minisystem/750-UTILITY/Panel/850_hole_centres.dxf

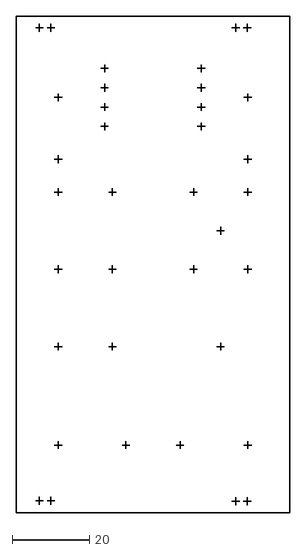
[picture p1: CAD file, 2017-03-22]
Panel/850_hole_centres.dxf
70.8 x 128.5
