minisystem/750-UTILITY/Panel/850_mechanical.dxf

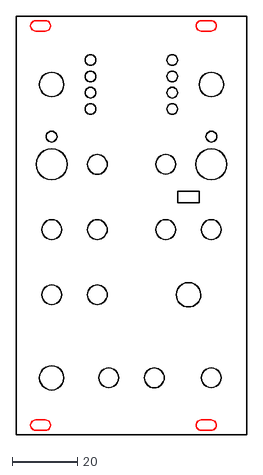
[picture p2: CAD file, 2017-03-22]
Panel/850_mechanical.dxf
70.8 x 128.5
