minisystem/750-UTILITY/Panel/750 LFO S&H NOISE SLEW-Edge.Cuts.dxf

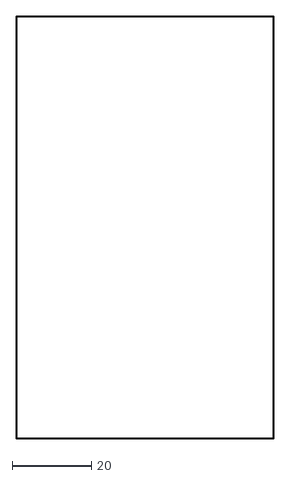
[picture p3: CAD file, 2017-03-21]
Panel/750 LFO S&H NOISE SLEW-Edge.Cuts.dxf
65.2 x 106.6
