minisystem/750-UTILITY/Panel/750 LFO S&H NOISE SLEW-Eco1.User.dxf

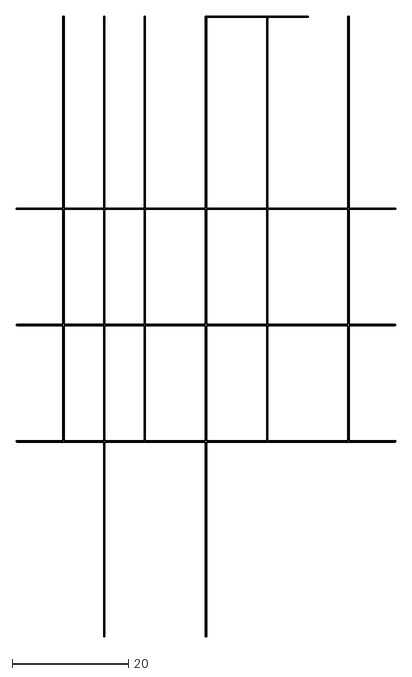
[picture p4: CAD file, 2017-03-21]
Panel/750 LFO S&H NOISE SLEW-Eco1.User.dxf
65.2 x 106.7
