minisystem/750-UTILITY/Panel/hole centres.dxf

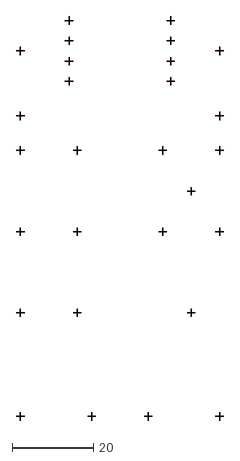
[picture p5: CAD file, 2016-12-11]
Panel/hole centres.dxf
51.0 x 99.5
