minisystem/750-UTILITY/Panel/panel outline.dxf

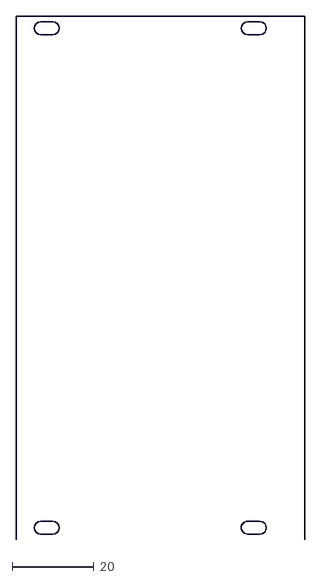
[picture p6: CAD file, 2016-12-10]
Panel/panel outline.dxf
70.8 x 128.5
