minisystem/750-UTILITY/(list of files, cad)

Other CAD files:
Panel/750 LFO S&H NOISE SLEW-F.SilkS.dxf
Panel/850_hole_centres.dwg
