minisystem/750-UTILITY/750 LFO S&H NOISE SLEW.pdf

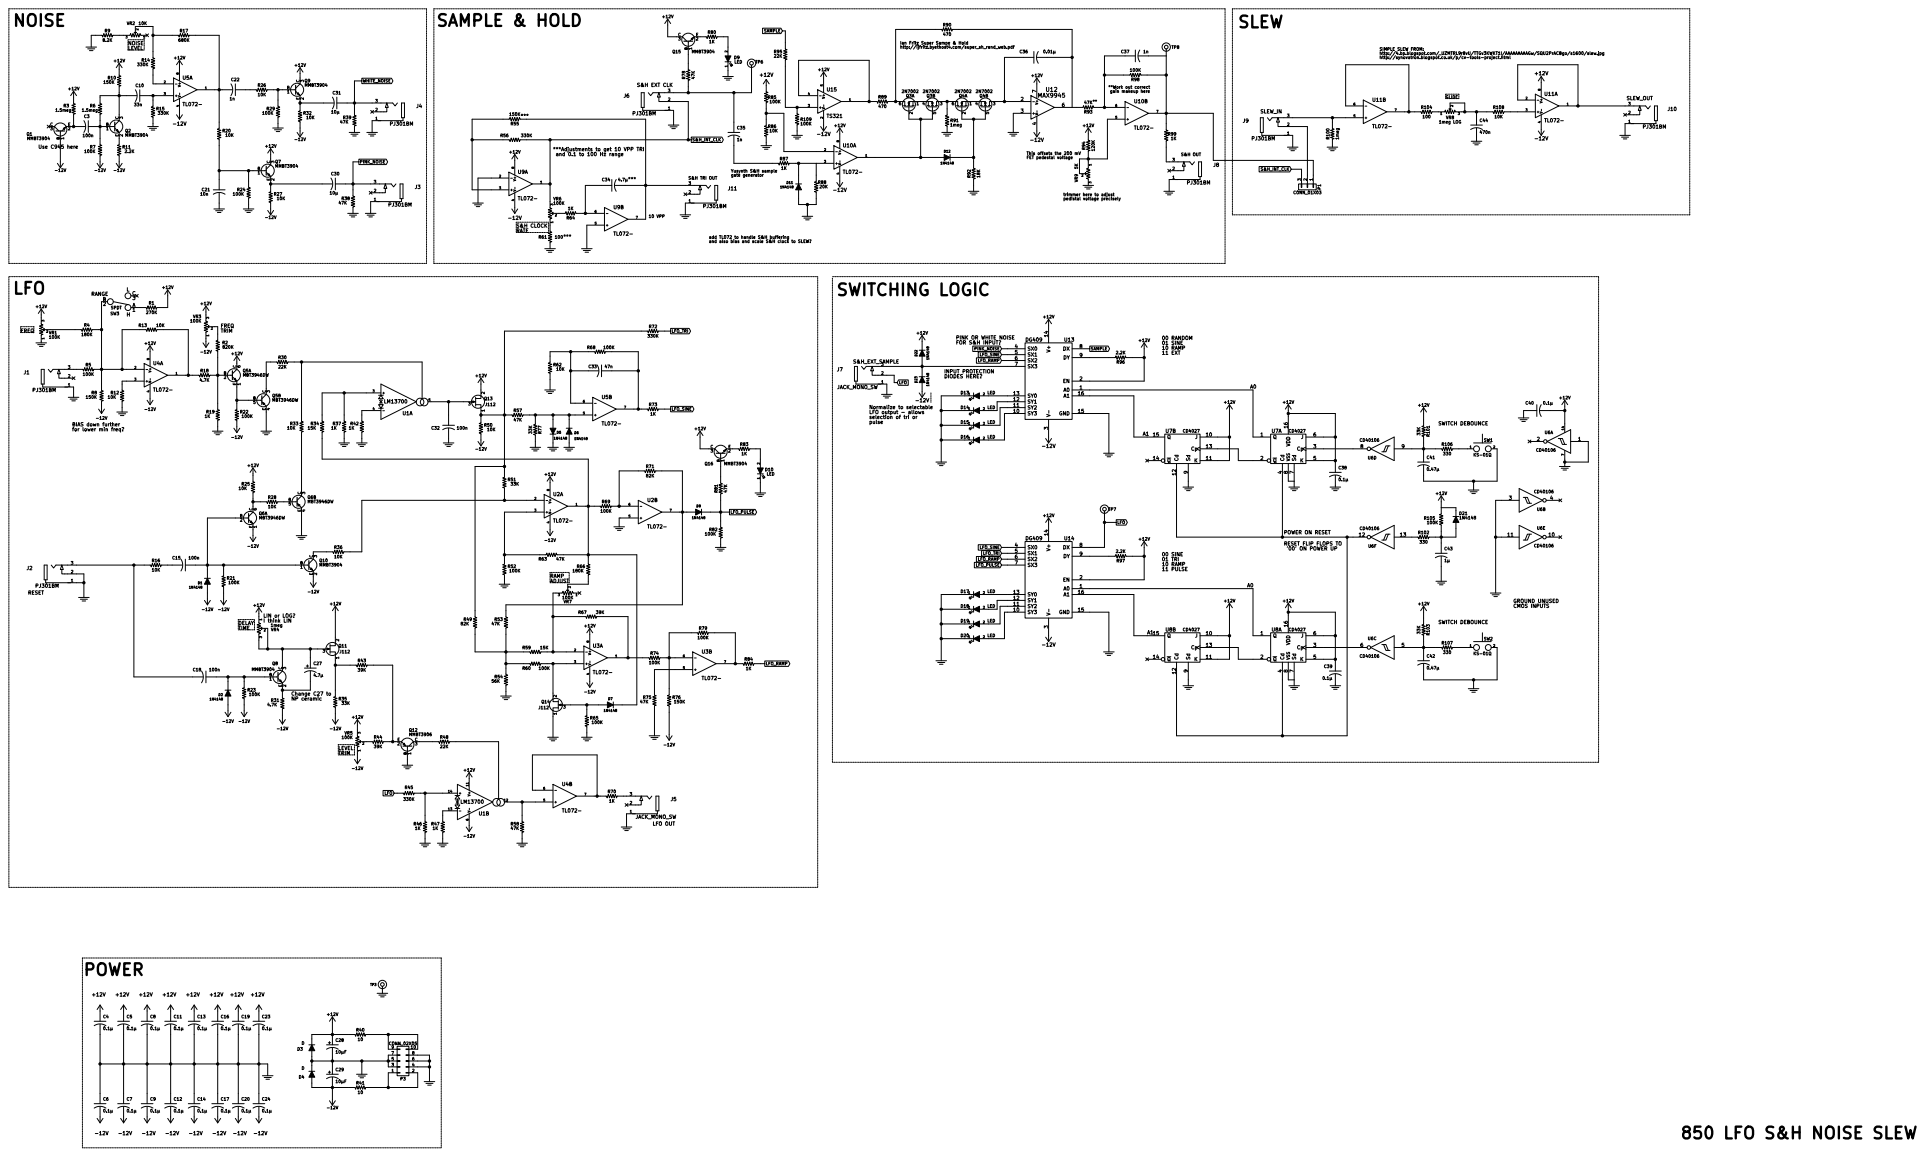
[picture p7: page 1]

Ian Fritz Super Sampe & Hold

100 SIMPLE SLEW FROM: http://4.bp.blogspot.com/_UZMTRL9r8vU/TTGv3KWKT1I/AAAAAAAAAGw/SQU2PrACBgo/s1600/slew.jpg

**Work out correct gain makeup here

***Adjustments to get 10 VPP TRI

This offsets the 200 mV FET pedestal voltage

trimmer here to adjust

and also bias and scale S&H clock to SLEW? BIAS down further

add TL072 to handle S&H buffering

PINK OR WHITE NOISE
FOR S&H INPUT?

LFO output - allows selection of tri or pulse

for lower min freq?

RESET FLIP FLOPS TO
'00' ON POWER UP

Change C27 to NP ceramic

0.1µ +12V POWER +12V | TP3
