minisystem/750-UTILITY/Panel/850_hole_centres.pdf

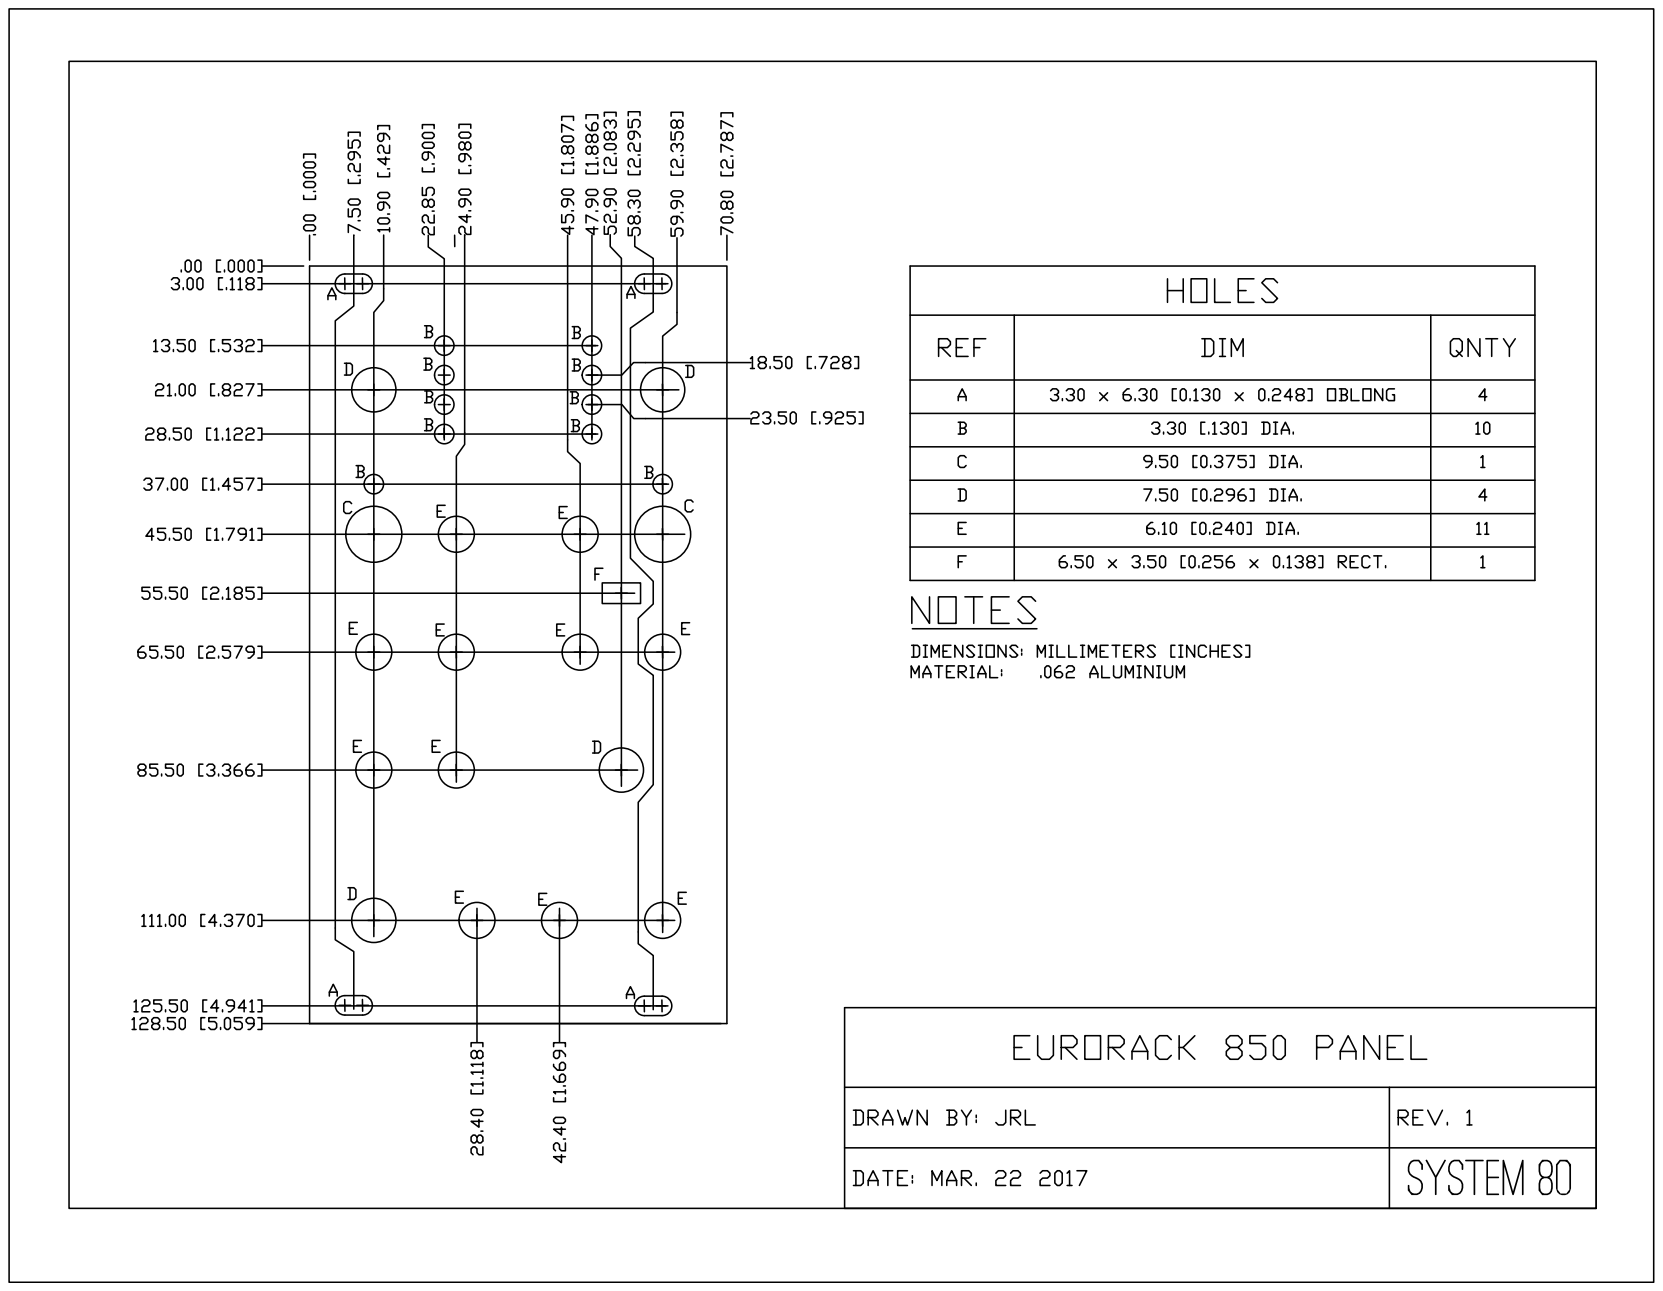
[picture p8: page 1]
