minisystem/750-UTILITY/Panel/750 LFO S&H NOISE SLEW-F.SilkS.pdf

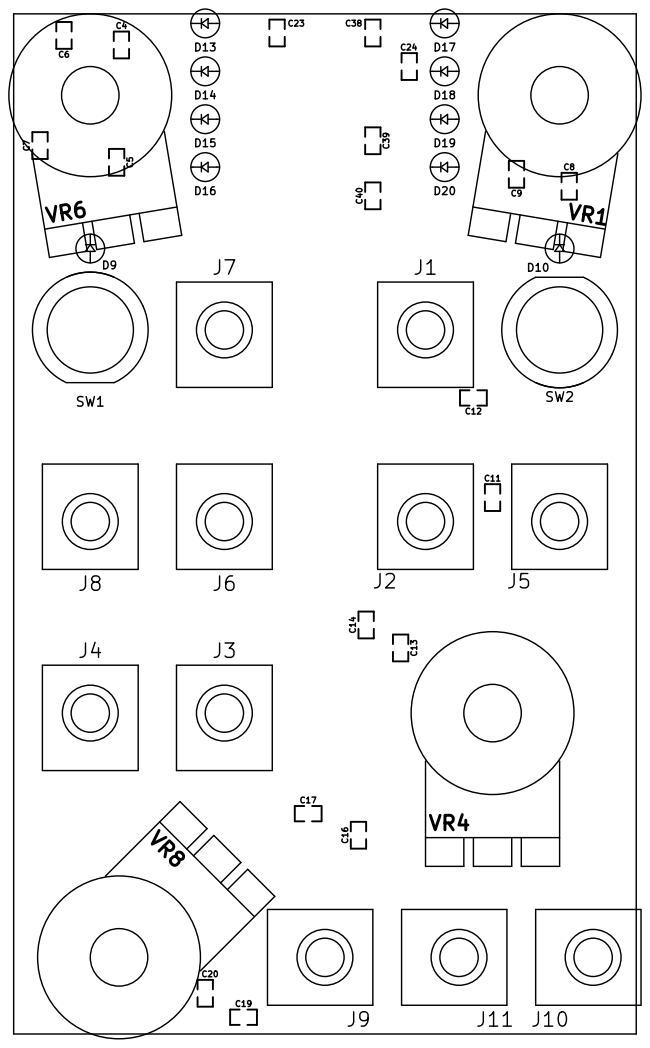
[picture p9: page 1]
