minisystem/750-UTILITY/Manual/850 Manual cover.pdf

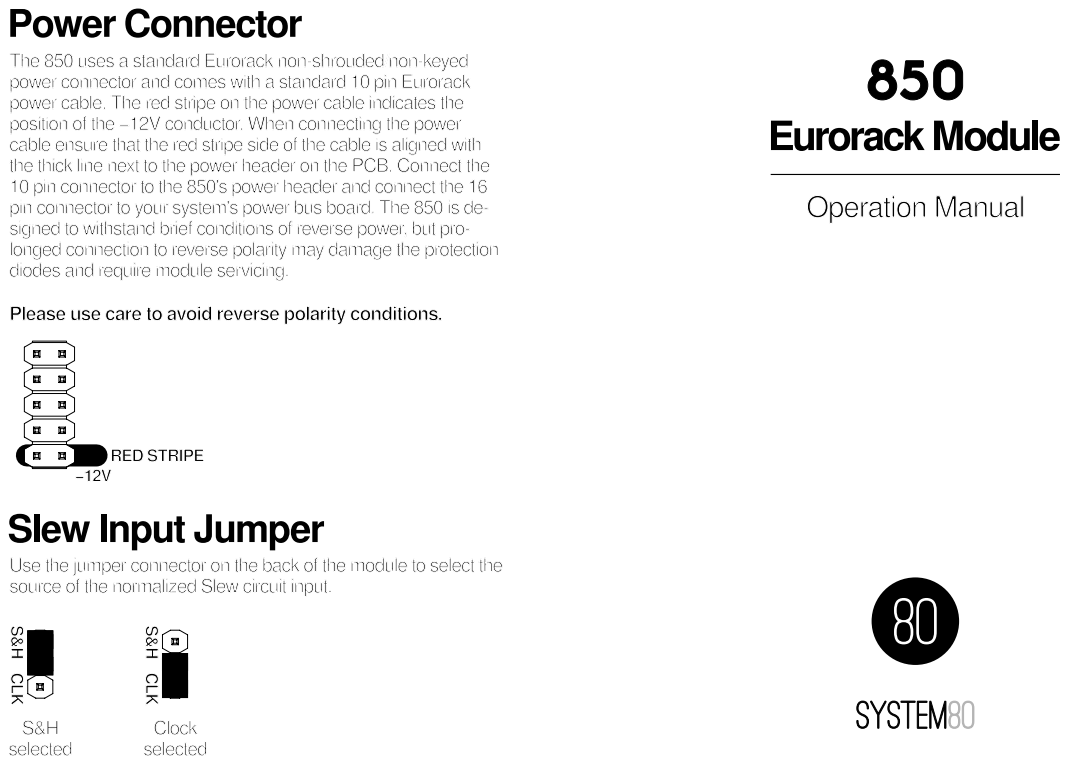
[picture p10: page 1]
