minisystem/750-UTILITY/Manual/850 Manual upload.pdf

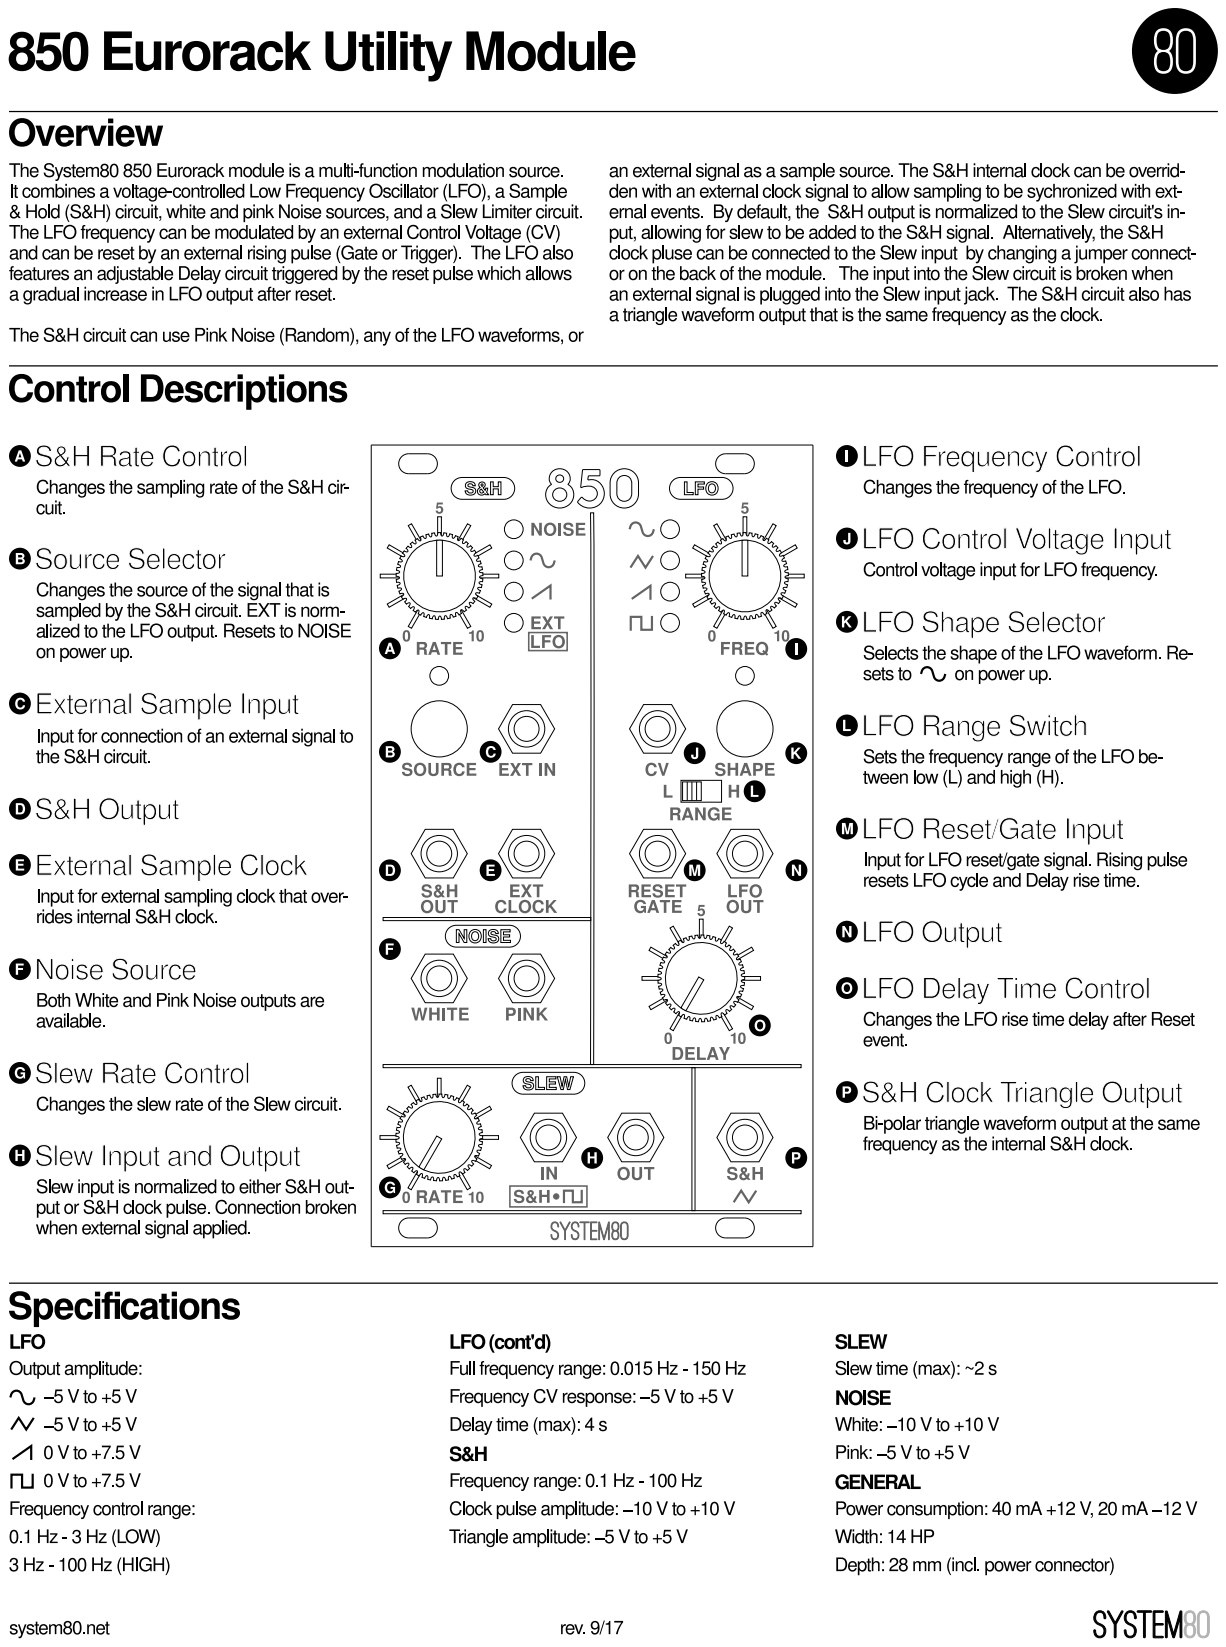
[picture p11: page 1]
