minisystem/750-UTILITY/Manual/850 Manual.pdf

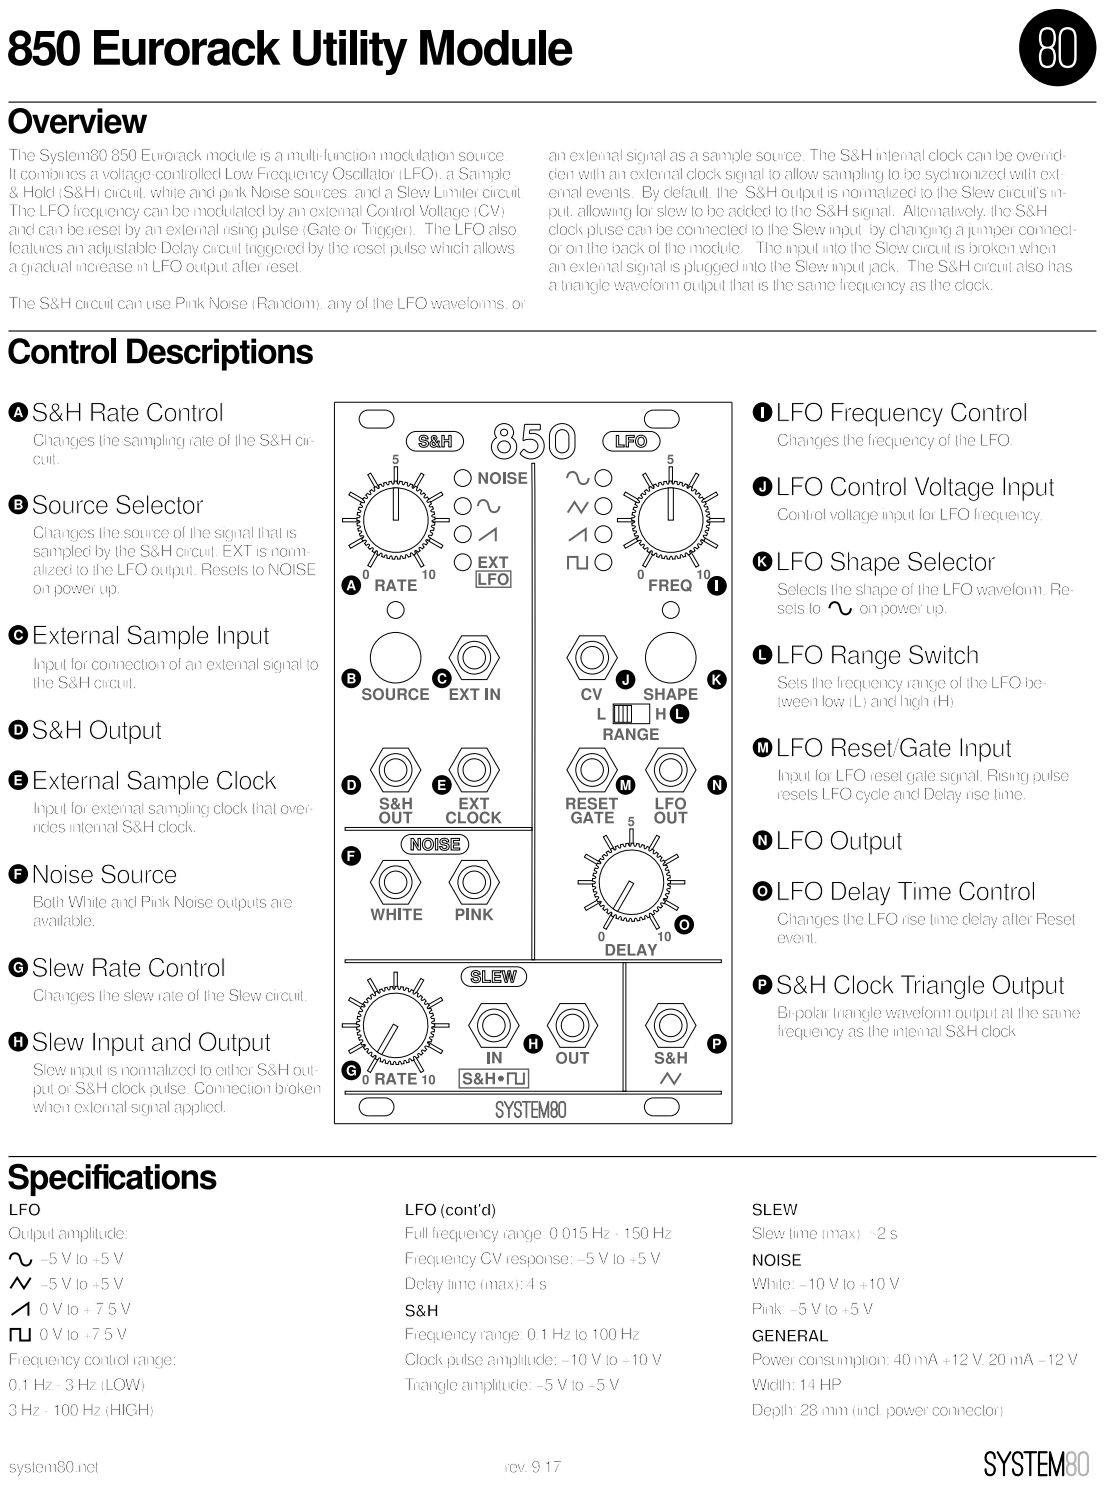
[picture p12: page 1]
