minisystem/750-UTILITY/750 LFO S&H NOISE SLEW.kicad_pcb

## KiCad design 750 LFO S&H NOISE SLEW.kicad_pcb (2018-03-14)

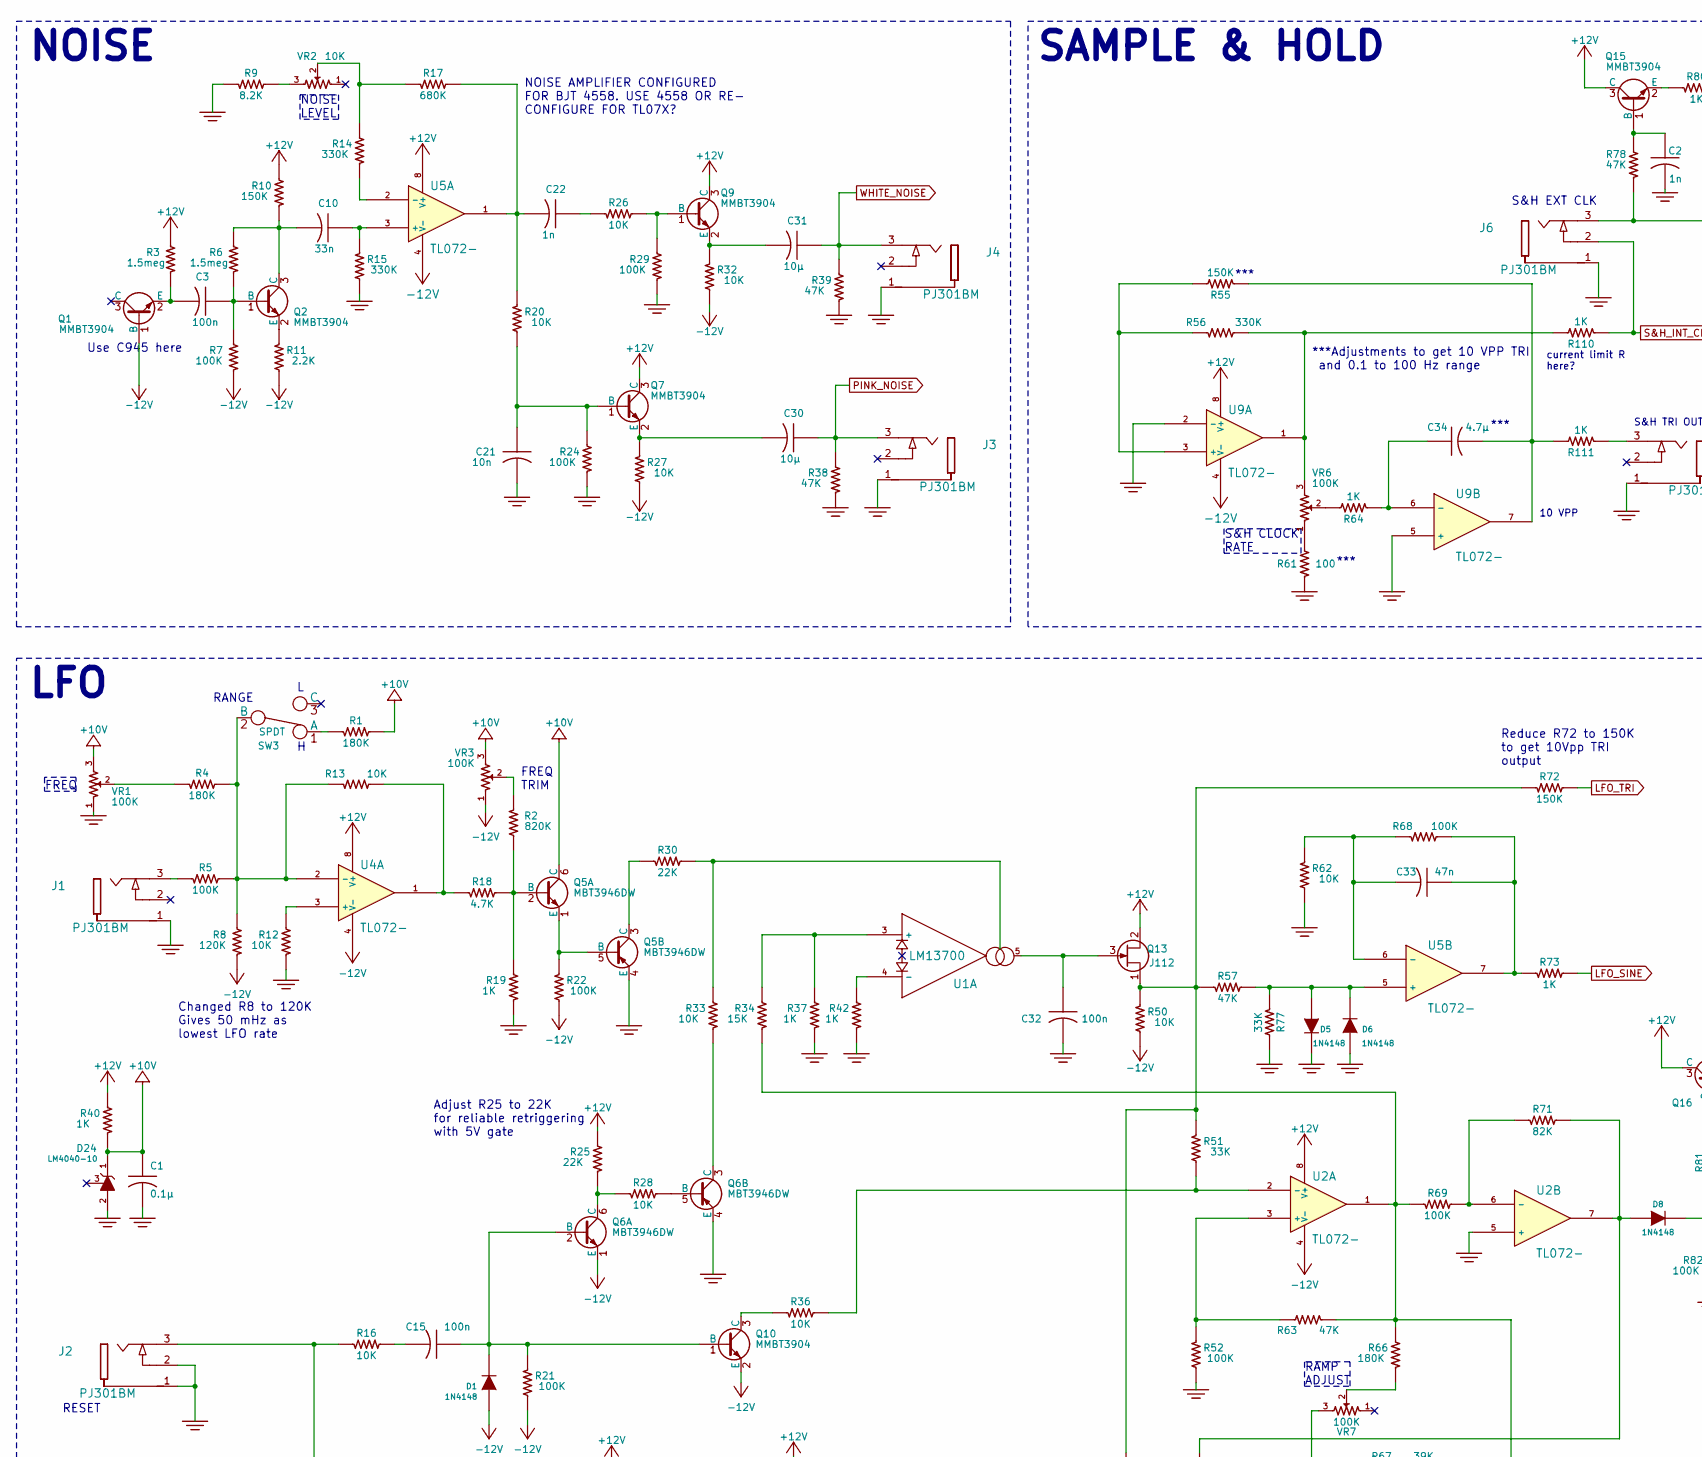
[picture p13: schematic 750 LFO S&H NOISE SLEW.sch, part in row 1, column 1]

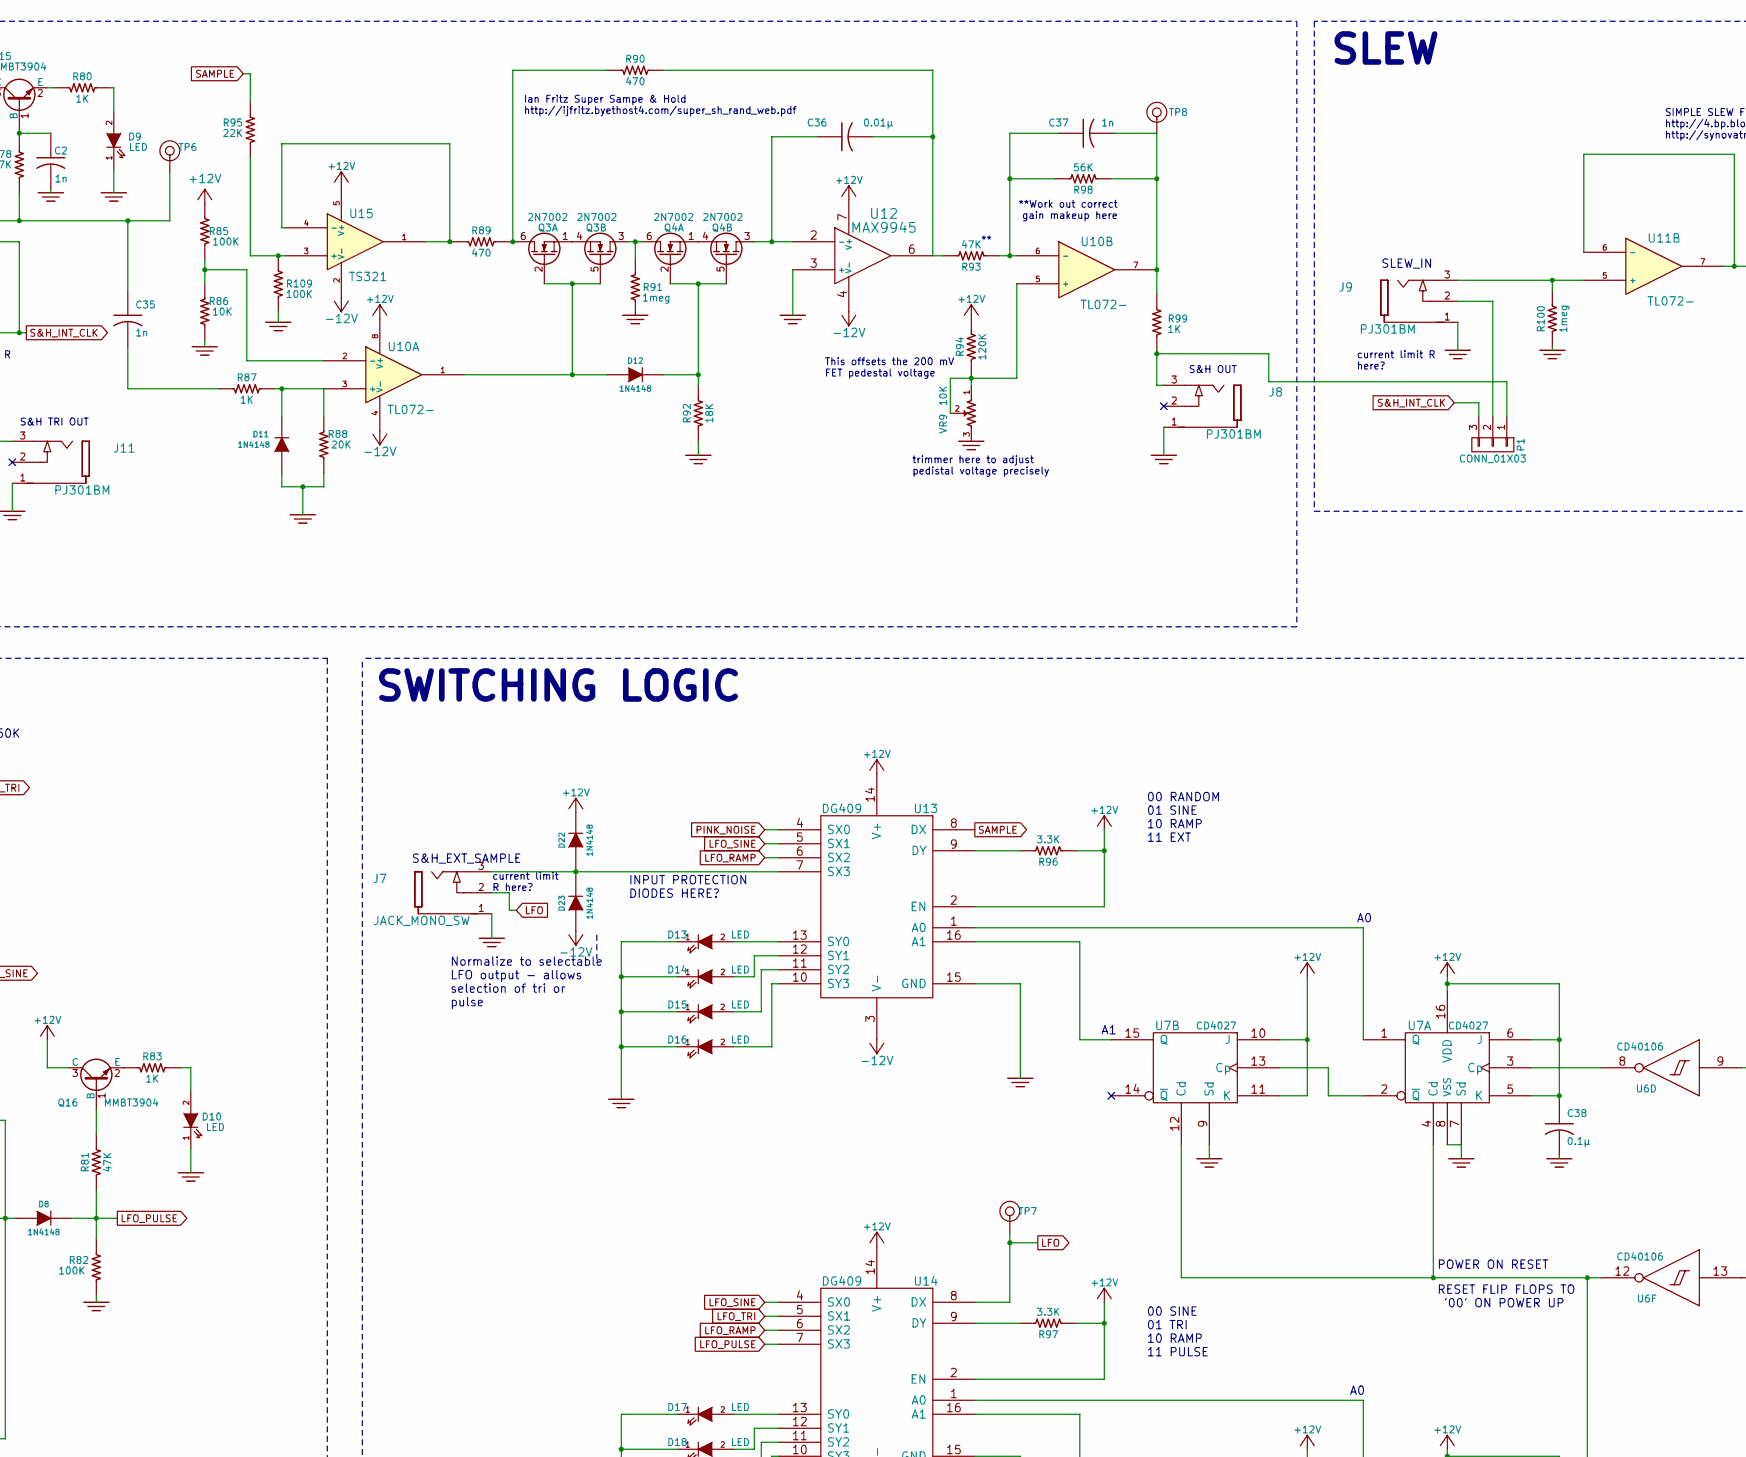
[picture p14: schematic 750 LFO S&H NOISE SLEW.sch, part in row 1, column 2]

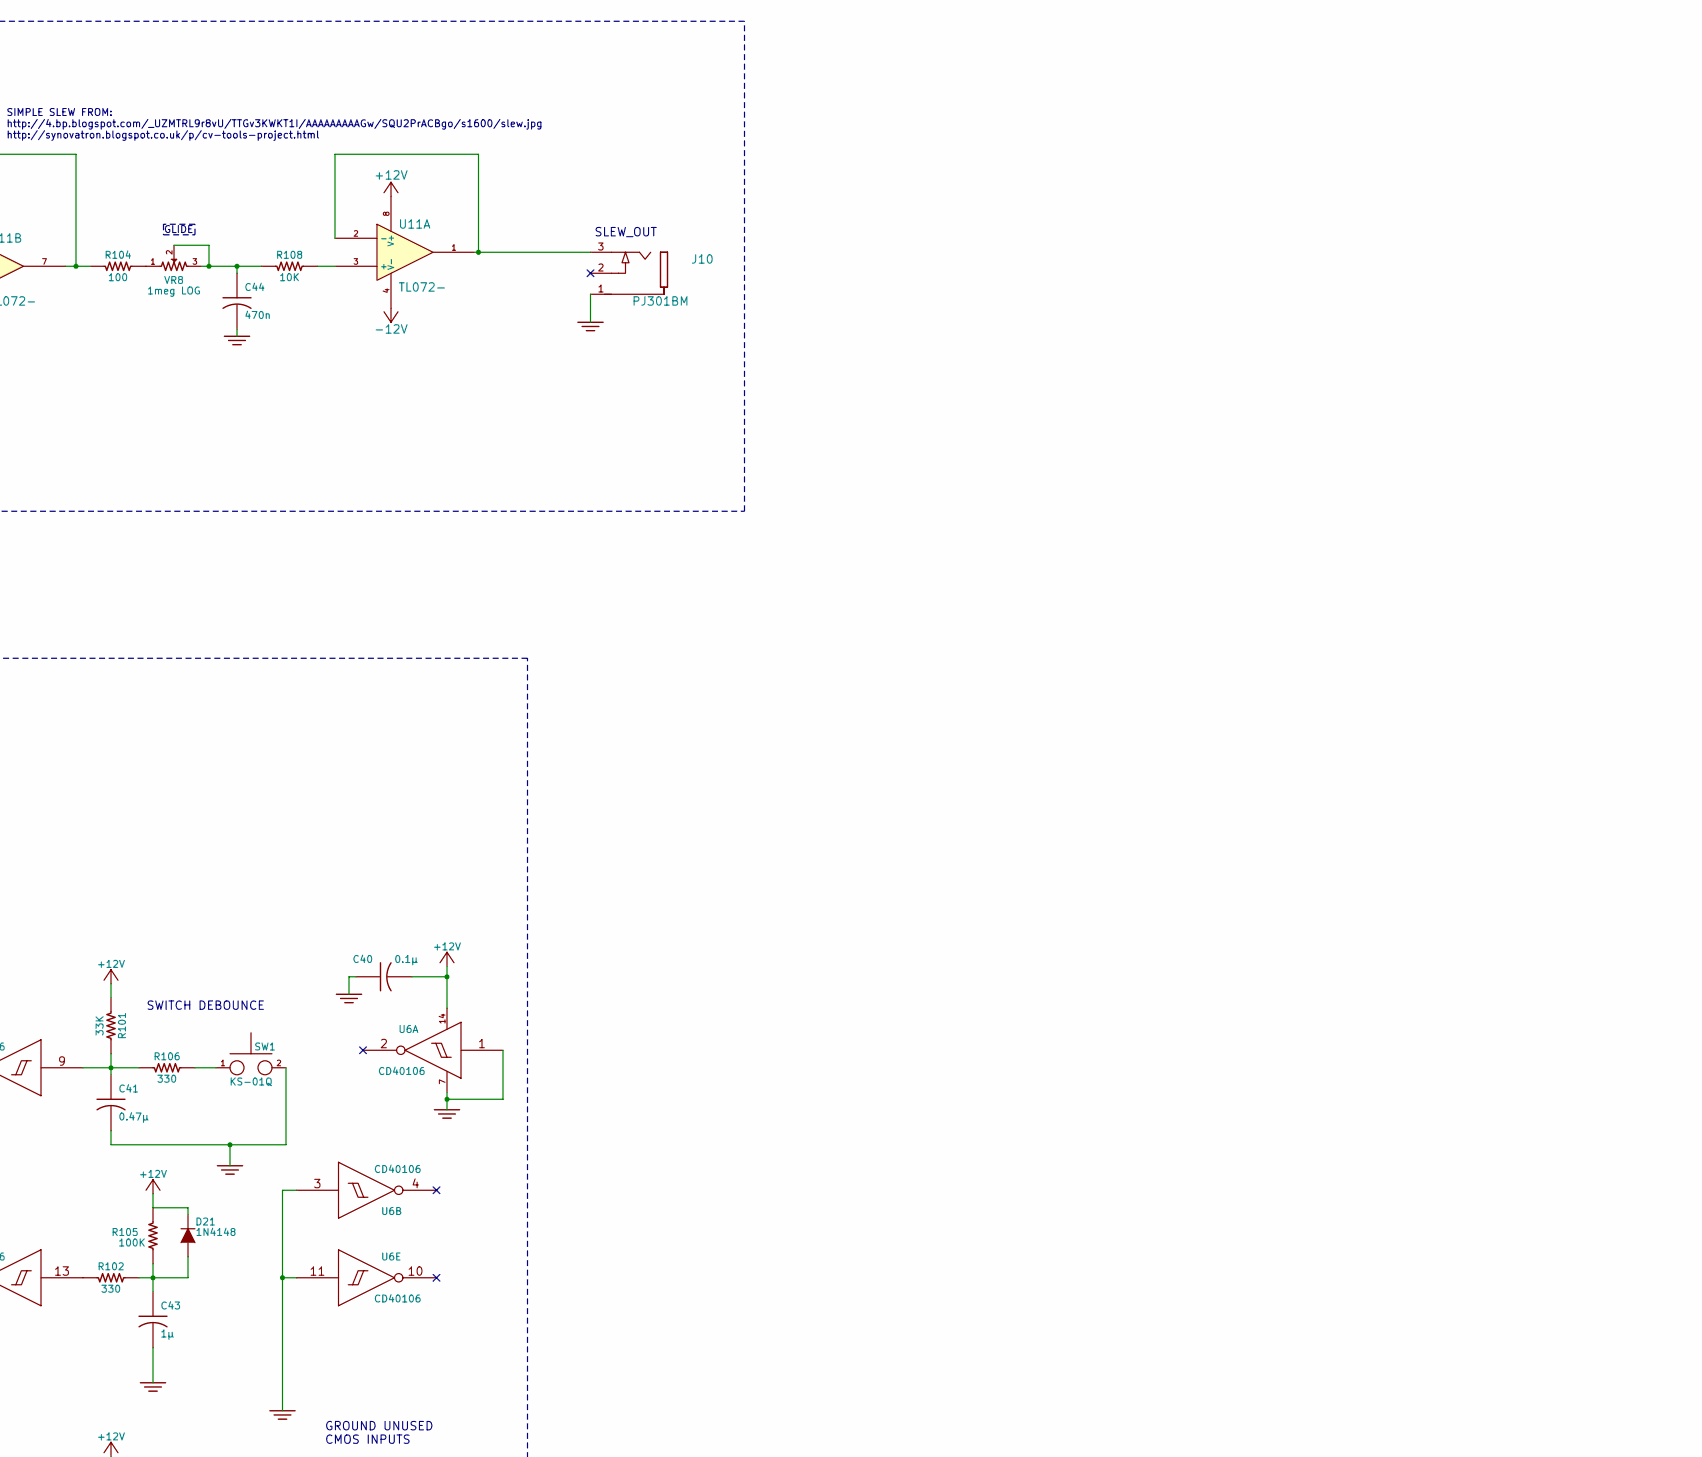
[picture p15: schematic 750 LFO S&H NOISE SLEW.sch, part in row 1, column 3]

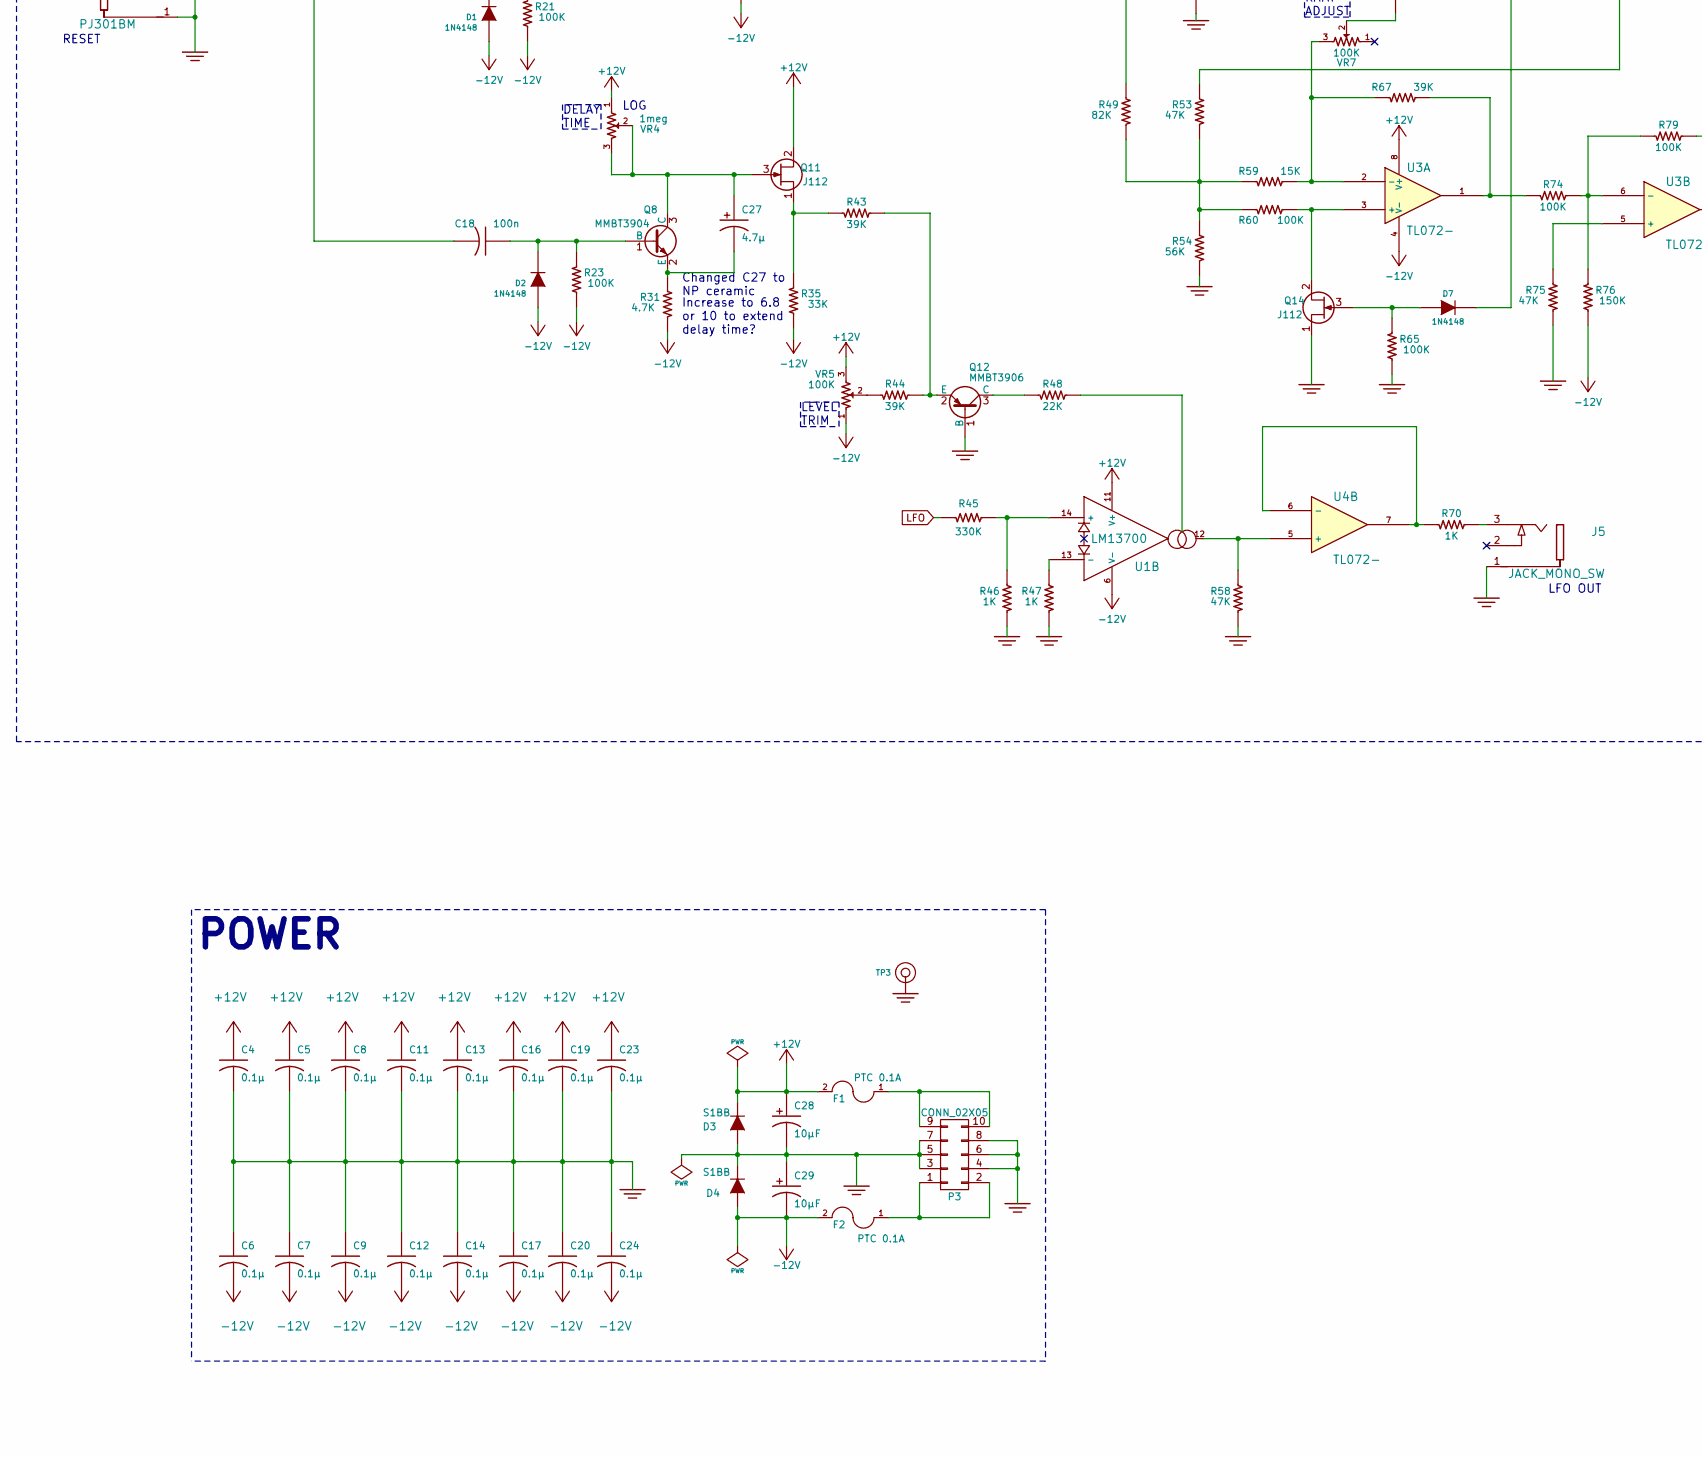
[picture p16: schematic 750 LFO S&H NOISE SLEW.sch, part in row 2, column 1]

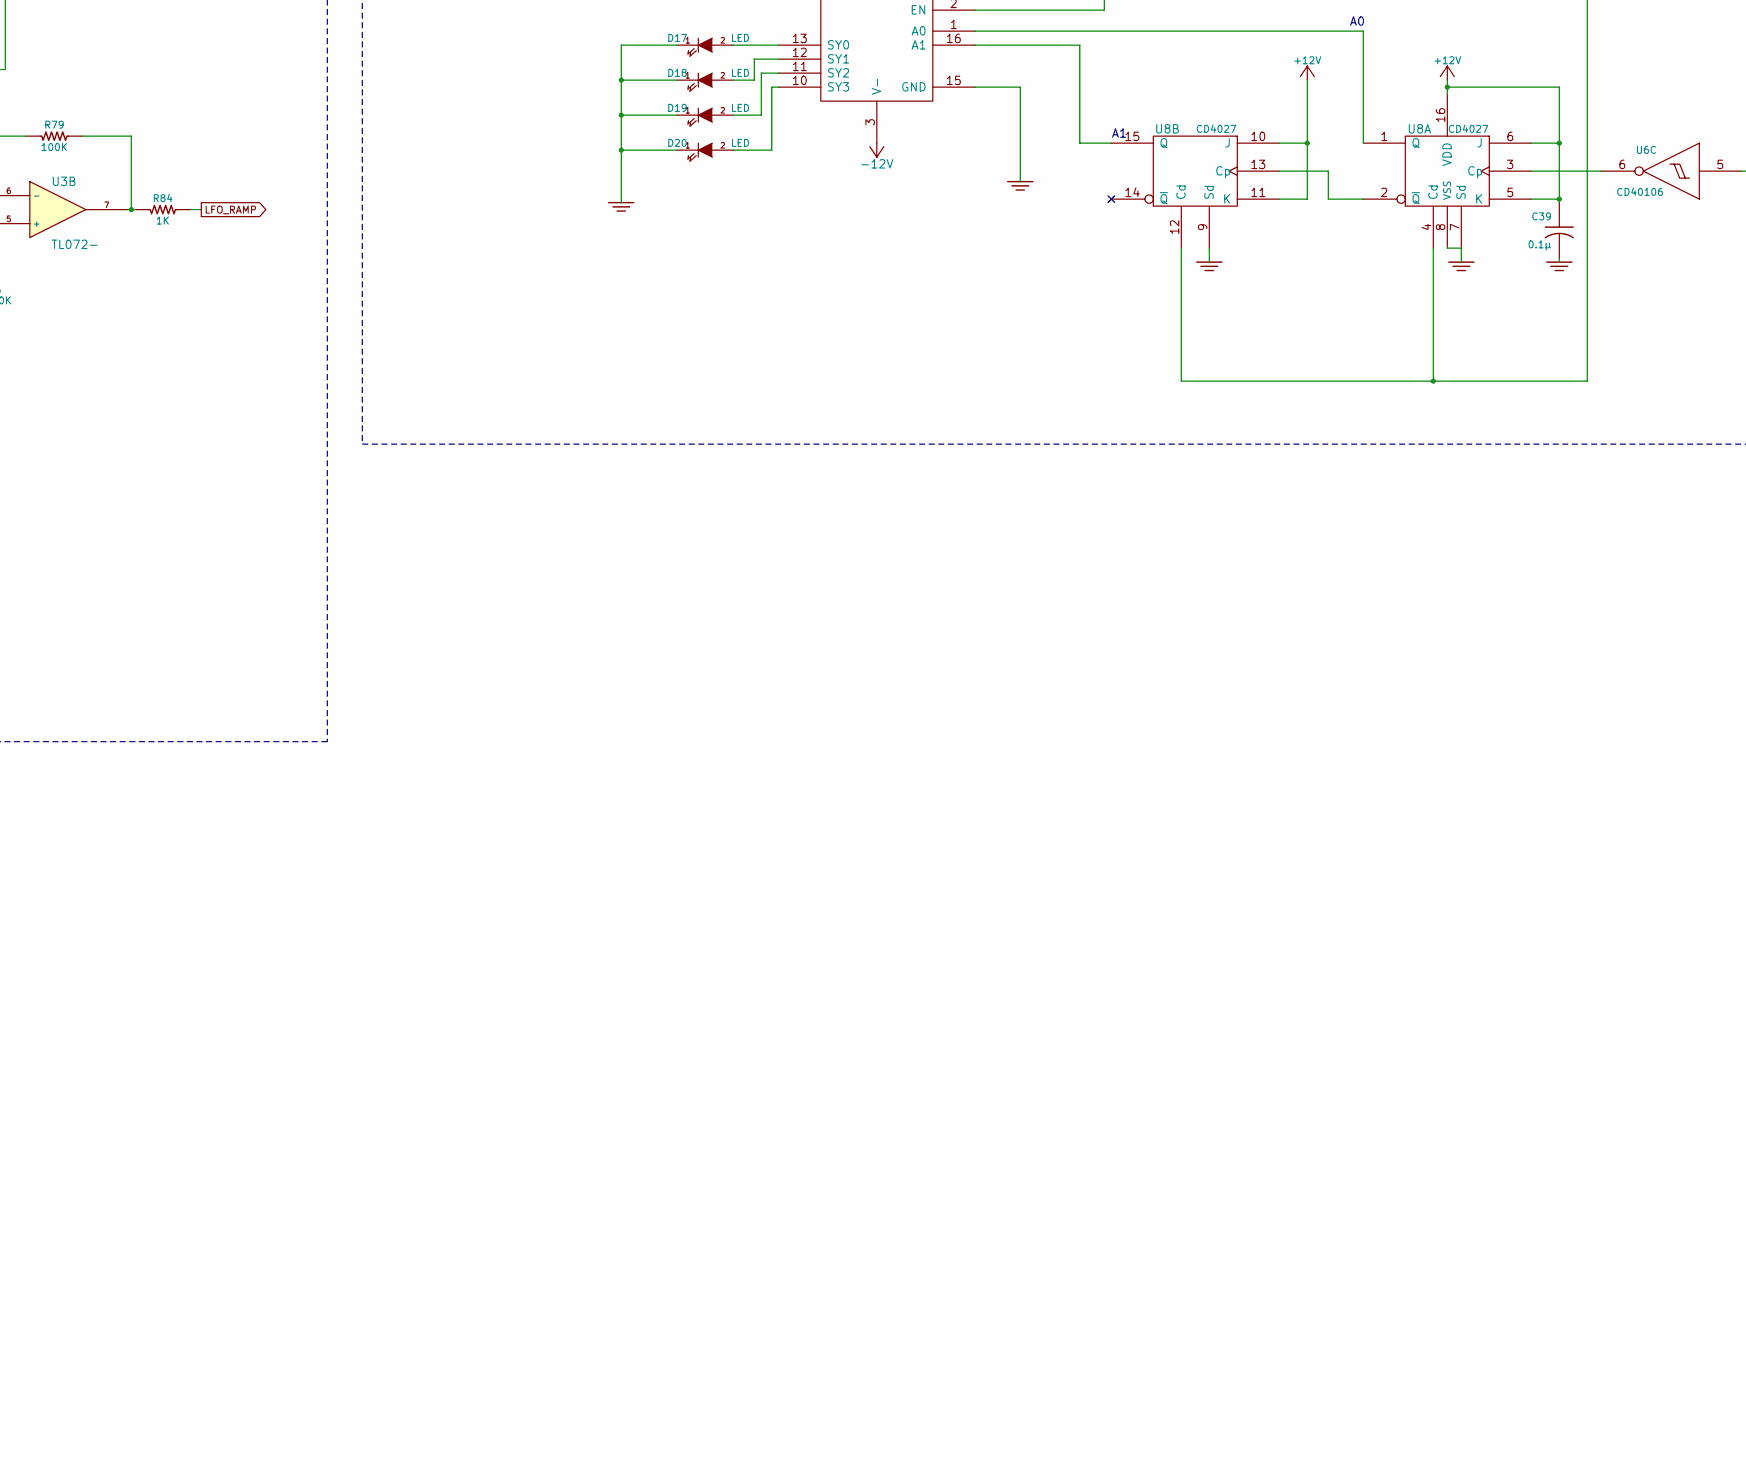
[picture p17: schematic 750 LFO S&H NOISE SLEW.sch, part in row 2, column 2]

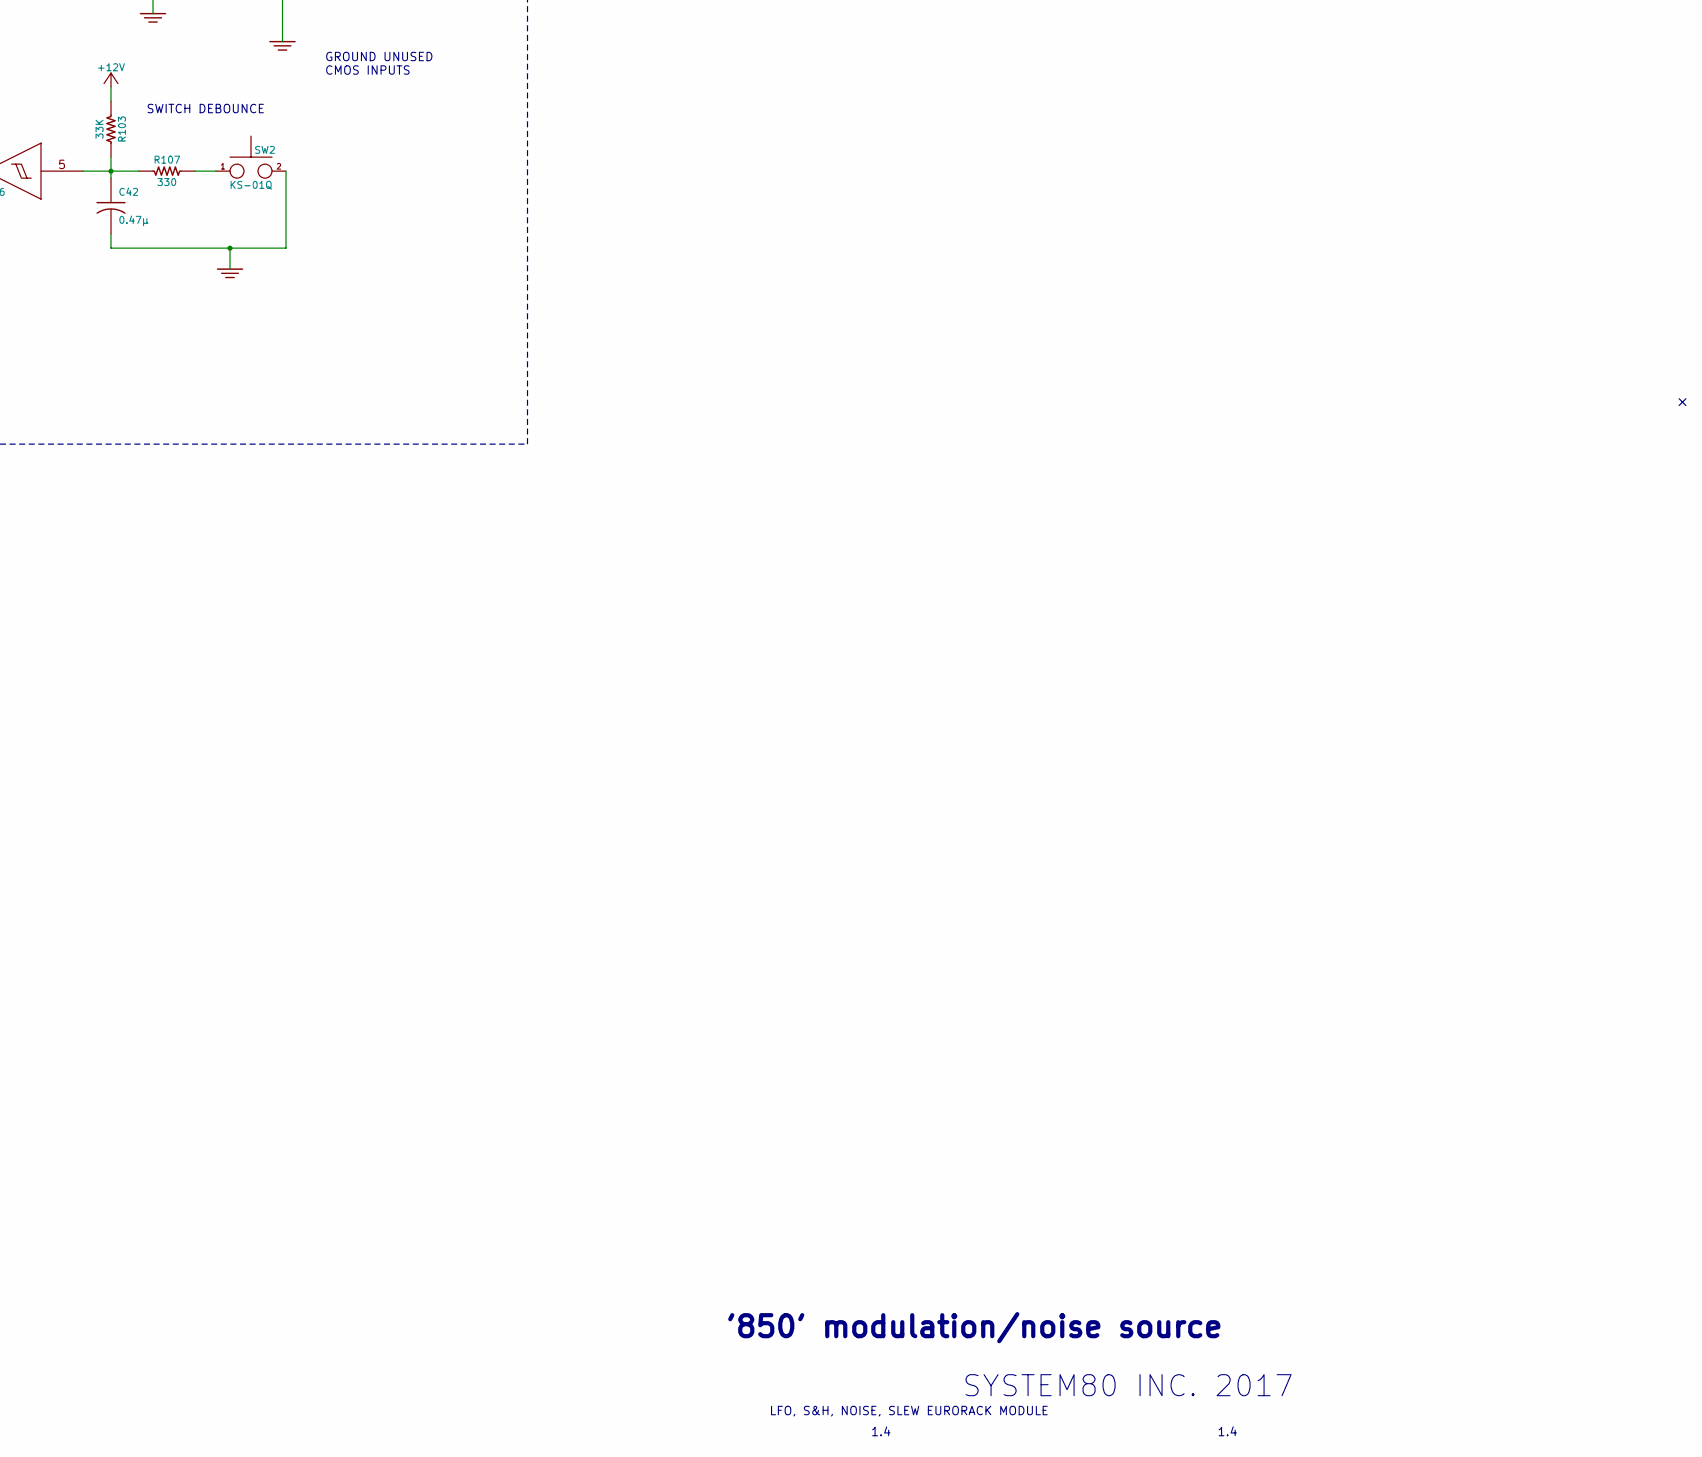
[picture p18: schematic 750 LFO S&H NOISE SLEW.sch, part in row 2, column 3]

Parts:
C1, C4, C5, C6, C7, C8, C9, C11, C12, C13, C14, C16, C17, C19, C20, C23, C24, C38, C39, C40: 0.1µ; SM0603-C-JRL
C2, C22, C35, C37: 1n; SM0603-C-JRL
C3, C15, C18, C32: 100n; SM0603-C-JRL
C10: 33n; SM0603-C-JRL
C21: 10n; SM0603-C-JRL
C27, C34: 4.7μ; SM0805-HAND
C28, C29: 10μF; c_elec_5x5.3
C30, C31: 10μ; SM0805-HAND
C33: 47n; SM0603-C-JRL
C36: 0.01μ; SM0603-C-JRL
C41, C42: 0.47μ; SM0603-C-JRL
C43: 1μ; SM0603-C-JRL
C44: 470n; CAP-5MM-BOX-0805-COMBO
D1, D2, D5, D6, D7, D8, D11, D12, D22, D23: 1N4148; SOD323-JRL
D3, D4: S1BB; SMB-1C2A
D9, D10, D13, D14, D15, D16, D17, D18, D19, D20: LED; 3MM-LED-C1A2
D21: 1N4148; SOD323-C1A2
D24: LM4040-10; SOT23-132-JRL
F1, F2: PTC 0.1A; C_0805
J1, J2, J3, J4, J6, J8, J9, J10, J11: PJ301BM; PJ-301B-JACK-SLOTS
J5, J7: JACK_MONO_SW; PJ-301B-JACK-SLOTS
P1: CONN_01X03; PAD_3
P3: CONN_02X05; Pin_Header_Straight_2x05
Q1, Q2, Q7, Q8, Q9, Q10, Q15, Q16: MMBT3904; SOT23-132-JRL
Q3, Q4: 2N7002; SOT363-JRL
Q5, Q6: MBT3946DW; SOT363-JRL
Q11, Q13, Q14: J112; SOT23-JRL
Q12: MMBT3906; SOT23-132-JRL
R1, R4, R66: 180K; SM0603-R-JRL
R2: 820K; SM0603-R-JRL
R3, R6: 1.5meg; SM0603-R-JRL
R5, R7, R21, R22, R23, R24, R29, R52, R60, R65, R68, R69, R74, R79, R82, R85, R105, R109: 100K; SM0603-R-JRL
R8, R94: 120K; SM0603-R-JRL
R9: 8.2K; SM0603-R-JRL
R10, R55, R72, R76: 150K; SM0603-R-JRL
R11: 2.2K; SM0603-R-JRL
R12, R13, R16, R20, R26, R27, R28, R32, R33, R36, R50, R62, R86, R108: 10K; SM0603-R-JRL
R14, R15, R45, R56: 330K; SM0603-R-JRL
R17: 680K; SM0603-R-JRL
R18, R31: 4.7K; SM0603-R-JRL
R19, R37, R40, R42, R46, R47, R64, R70, R73, R80, R83, R84, R87, R99, R110, R111: 1K; SM0603-R-JRL
R25, R30, R48, R95: 22K; SM0603-R-JRL
R34, R59: 15K; SM0603-R-JRL
R35, R51, R77, R101, R103: 33K; SM0603-R-JRL
R38, R39, R53, R57, R58, R63, R75, R78, R81, R93: 47K; SM0603-R-JRL
R43, R44, R67: 39K; SM0603-R-JRL
R49, R71: 82K; SM0603-R-JRL
R54, R98: 56K; SM0603-R-JRL
R61, R104: 100; SM0603-R-JRL
R88: 20K; SM0603-R-JRL
R89, R90: 470; SM0603-R-JRL
R91, R100: 1meg; SM0603-R-JRL
R92: 18K; SM0603-R-JRL
R96, R97: 3.3K; SM0603-R-JRL
R102, R106, R107: 330; SM0603-R-JRL
SW1, SW2: KS-01Q; KS-01Q-02-JRL
SW3: SPDT; SS-12F45-1P2T-SLIDE
TP3: CONN_1; TEST_POINT_LOOP_4592
TP6, TP7, TP8: CONN_1; TEST_POINT_SMALL
U1: LM13700; SO16-JRL
U2, U3, U4, U5, U9, U10, U11: TL072-; TSSOP8-JRL
U6: CD40106; TSSOP-14_4.4x5mm_Pitch0.65mm
U7, U8: CD4027; TSSOP-16_4.4x5mm_Pitch0.65mm
U12: MAX9945; MSOP-8_3x3mm_Pitch0.65mm
U13, U14: DG409; SO16-JRL
U15: TS321; SOT-23-5
VR1, VR6: 100K; RV16A-41-JRL
VR2, VR9: 10K; TC33X-2
VR3, VR5, VR7: 100K; TC33X-2
VR4: 1meg; RV16A-41-JRL
VR8: 1meg LOG; RV16A-41-JRL

Connections:
+10V: C1.1, D24.1 (K), Q5.6 (C), R1.2, R40.2, VR1.3, VR3.3
+12V: C4.1, C5.1, C8.1, C11.1, C13.1, C16.1, C19.1, C23.1, C28.1 (+), C38.1, C39.1, C40.2, D3.1 (K), D21.1 (K), D22.2 (K), F1.2, Q7.3 (C), Q9.3 (C), Q11.2 (D), Q13.2 (D), Q15.3 (C), Q16.3 (C), R3.1, R10.1, R25.1, R40.1, R85.2, R94.2, R96.1, R97.1, R101.2, R103.2, R105.2, U1.11 (V+), U2.8 (V+), U3.8 (V+), U4.8 (V+), U5.8 (V+), U6.14 (VDD), U7.5 (K), U7.6 (J), U7.10 (J), U7.11 (K), U7.16 (VDD), U8.5 (K), U8.6 (J), U8.10 (J), U8.11 (K), U8.16 (VDD), U9.8 (V+), U10.8 (V+), U11.8 (V+), U12.7 (V+), U13.2 (EN), U13.14 (V+), U14.2 (EN), U14.14 (V+), U15.5 (V+), VR4.1, VR5.3
-12V: C6.2, C7.2, C9.2, C12.2, C14.2, C17.2, C20.2, C24.2, C29.2 (-), D1.1 (A), D2.1 (A), D4.2 (A), D23.1 (A), F2.2, Q1.1 (B), Q6.1 (E), Q10.2 (E), R7.2, R8.2, R11.2, R21.2, R22.2, R23.2, R27.2, R31.2, R32.2, R35.2, R50.2, R76.2, U1.6 (V-), U2.4 (V-), U3.4 (V-), U4.4 (V-), U5.4 (V-), U9.4 (V-), U10.4 (V-), U11.4 (V-), U12.4 (V-), U13.3 (V-), U14.3 (V-), U15.2 (V-), VR3.1, VR5.1
GND: C1.2, C2.2, C4.2, C5.2, C6.1, C7.1, C8.2, C9.1, C11.2, C12.1, C13.2, C14.1, C16.2, C17.1, C19.2, C20.1, C21.2, C23.2, C24.1, C28.2 (-), C29.1 (+), C32.2, C38.2, C39.2, C40.1, C41.2, C42.2, C43.2, C44.2, D3.2 (A), D4.1 (K), D5.2 (K), D6.1 (A), D9.1 (K), D10.1 (K), D11.1 (A), D13.1 (K), D14.1 (K), D15.1 (K), D16.1 (K), D17.1 (K), D18.1 (K), D19.1 (K), D20.1 (K), D24.2 (A), J1.1, J2.1, J2.2, J3.1, J4.1, J5.1, J6.1, J7.1, J8.1, J9.1, J10.1, J11.1, P3.3, P3.4, P3.5, P3.6, P3.7, P3.8, Q5.4 (E), Q6.4 (E), Q12.1 (B), Q14.1 (S), R9.1, R12.2, R15.2, R19.2, R24.2, R29.2, R37.2, R38.2, R39.2, R42.2, R46.2, R47.2, R52.2, R54.2, R58.2, R61.1, R62.2, R65.2, R75.2, R77.2, R82.2, R86.2, R88.2, R91.2, R92.1, R100.2, R109.1, SW1.2, SW2.2, TP3.1, U2.5 (+), U6.1 (In), U6.3 (In), U6.7 (VSS), U6.11 (In), U7.7 (Sd), U7.8 (VSS), U7.9 (Sd), U8.7 (Sd), U8.8 (VSS), U8.9 (Sd), U9.2 (-), U9.5 (+), U12.3 (+), U13.15 (GND), U14.15 (GND), VR1.1, VR9.3
LFO: J7.2, R45.2, TP7.1, U14.8 (DX)
LFO_PULSE: D8.2 (K), R81.1, R82.1, U14.7 (SX3)
LFO_RAMP: R84.2, U13.6 (SX2), U14.6 (SX2)
LFO_SINE: R73.2, U13.5 (SX1), U14.4 (SX0)
LFO_TRI: R72.2, U14.5 (SX1)
unnamed: C2.1, Q15.1 (B), R78.2
unnamed: C3.1, Q2.1 (B), R6.2, R7.1
unnamed: C3.2, Q1.2 (E), R3.2
unnamed: C10.1, R15.1, U5.3 (+)
unnamed: C10.2, Q2.3 (C), R6.1, R10.2
unnamed: C15.1, D1.2 (K), Q6.2 (B), Q10.1 (B), R21.1
unnamed: C15.2, R16.2
unnamed: C18.1, D2.2 (K), Q8.1 (B), R23.1
unnamed: C18.2, J2.3, R16.1
unnamed: C21.1, Q7.1 (B), R20.2, R24.1
unnamed: C22.1, R26.1
unnamed: C22.2, R17.2, R20.1, U5.1
unnamed: C27.1 (+), Q8.3 (C), Q11.3 (G), VR4.2, VR4.3
unnamed: C27.2 (-), Q8.2 (E), R31.1
unnamed: C30.2, Q7.2 (E), R27.1
unnamed: C31.2, Q9.2 (E), R32.1
unnamed: C32.1, Q13.3 (G), U1.5
unnamed: C33.1, R68.2, R73.1, U5.7
unnamed: C33.2, R62.1, R68.1, U5.6 (-)
unnamed: C34.1, R64.1, U9.6 (-)
unnamed: C34.2, R55.1, R111.2, U9.7
unnamed: C35.1, J6.3, R78.1, TP6.1
unnamed: C35.2, R87.1
unnamed: C36.1, Q4.3 (D), U12.2 (-)
unnamed: C36.2, R90.1, R93.2, U12.6
unnamed: C37.1, R93.1, R98.2, U10.6 (-)
unnamed: C37.2, R98.1, R99.2, TP8.1, U10.7
unnamed: C41.1, R101.1, R106.1, U6.9 (In)
unnamed: C42.1, R103.1, R107.1, U6.5 (In)
unnamed: C43.1, D21.2 (A), R102.2, R105.1
unnamed: C44.1, R108.2, VR8.2, VR8.3
unnamed: D5.1 (A), D6.2 (K), R57.2, R77.1, U5.5 (+)
unnamed: D7.1 (A), Q14.3 (G), R65.1
unnamed: D7.2 (K), R34.2, R63.2, R66.1, R69.1, U2.1
unnamed: D8.1 (A), R53.1, R71.2, U2.7
unnamed: D9.2 (A), R80.2
unnamed: D10.2 (A), R83.2
unnamed: D11.2 (K), R87.2, R88.1, U10.3 (+)
unnamed: D12.1 (A), Q3.2 (G), Q3.5 (G), U10.1
unnamed: D12.2 (K), Q4.2 (G), Q4.5 (G), R92.2
unnamed: D13.2 (A), U13.13 (SY0)
unnamed: D14.2 (A), U13.12 (SY1)
unnamed: D15.2 (A), U13.11 (SY2)
unnamed: D16.2 (A), U13.10 (SY3)
unnamed: D17.2 (A), U14.13 (SY0)
unnamed: D18.2 (A), U14.12 (SY1)
unnamed: D19.2 (A), U14.11 (SY2)
unnamed: D20.2 (A), U14.10 (SY3)
unnamed: D22.1 (A), D23.2 (K), J7.3, U13.7 (SX3)
unnamed: F1.1, P3.9, P3.10
unnamed: F2.1, P3.1, P3.2
unnamed: J1.3, R5.1
unnamed: J5.3, R70.2
unnamed: J8.3, P1.1, R99.1
unnamed: J9.2, P1.2
unnamed: J9.3, R100.1, U11.5 (+)
unnamed: J10.3, U11.1, U11.2 (-)
unnamed: J11.3, R111.1
unnamed: Q2.2 (E), R11.1
unnamed: Q3.1 (S), Q3.4 (S)
unnamed: Q3.3 (D), Q4.6 (D), R91.1
unnamed: Q3.6 (D), R89.1, R90.2
unnamed: Q4.1 (S), Q4.4 (S)
unnamed: Q5.1 (E), Q5.5 (B), R22.1
unnamed: Q5.2 (B), R2.2, R18.2, R19.1
unnamed: Q5.3 (C), R30.1
unnamed: Q6.3 (C), R33.2
unnamed: Q6.5 (B), R28.2
unnamed: Q6.6 (C), R25.2, R28.1
unnamed: Q9.1 (B), R26.2, R29.1
unnamed: Q10.3 (C), R36.1
unnamed: Q11.1 (S), R35.1, R43.1
unnamed: Q12.2 (E), R43.2, R44.2
unnamed: Q12.3 (C), R48.1
unnamed: Q13.1 (S), R49.1, R50.1, R51.1, R57.1, R72.1
unnamed: Q14.2 (D), R60.2, U3.3 (+)
unnamed: Q15.2 (E), R80.1
unnamed: Q16.1 (B), R81.2
unnamed: Q16.2 (E), R83.1
unnamed: R1.1, SW3.1 (A)
unnamed: R2.1, VR3.2
unnamed: R4.1, VR1.2
unnamed: R9.2, VR2.3
unnamed: R12.1, U4.3 (+)
unnamed: R4.2, R5.2, R8.1, R13.1, SW3.2 (B), U4.2 (-)
unnamed: R13.2, R18.1, U4.1
unnamed: R14.1, R17.1, VR2.2
unnamed: R14.2, U5.2 (-)
unnamed: R30.2, R33.1, U1.1
unnamed: R34.1, R37.1, U1.3 (+)
unnamed: R36.2, R51.2, U2.2 (-)
unnamed: R42.1, U1.4 (-)
unnamed: R44.1, VR5.2
unnamed: R45.1, R46.1, U1.14 (+)
unnamed: R47.1, U1.13 (-)
unnamed: R48.2, U1.16
unnamed: R49.2, R53.2, R54.1, R59.1, R60.1
unnamed: R52.1, R63.1, U2.3 (+)
unnamed: R55.2, R56.2, U9.3 (+)
unnamed: R58.1, U1.12, U4.5 (+)
unnamed: R59.2, R67.1, U3.2 (-), VR7.3
unnamed: R61.2, VR6.1
unnamed: R64.2, VR6.2
unnamed: R66.2, VR7.2
unnamed: R67.2, R74.1, U3.1
unnamed: R69.2, R71.1, U2.6 (-)
unnamed: R70.1, U4.6 (-), U4.7
unnamed: R74.2, R76.1, R79.1, U3.6 (-)
unnamed: R75.1, U3.5 (+)
unnamed: R79.2, R84.1, U3.7
unnamed: R85.1, R86.1, U10.2 (-)
unnamed: R89.2, U15.1, U15.4 (-)
unnamed: R94.1, U10.5 (+), VR9.1, VR9.2
unnamed: R96.2, U13.9 (DY)
unnamed: R97.2, U14.9 (DY)
unnamed: R102.1, U6.13 (In)
unnamed: R104.1, VR8.1
unnamed: R104.2, U11.6 (-), U11.7
unnamed: R106.2, SW1.1
unnamed: R107.2, SW2.1
unnamed: R108.1, U11.3 (+)
unnamed: R95.1, R109.2, U15.3 (+)
unnamed: R56.1, R110.2, U9.1, VR6.3
unnamed: U6.6 (Out), U8.3 (Cp)
unnamed: U6.8 (Out), U7.3 (Cp)
unnamed: U6.12 (Out), U7.4 (Cd), U7.12 (Cd), U8.4 (Cd), U8.12 (Cd)
unnamed: U7.2 (~Q), U7.13 (Cp)
unnamed: U8.2 (~Q), U8.13 (Cp)
unnamed: U7.1 (Q), U13.1 (A0)
unnamed: U7.15 (Q), U13.16 (A1)
unnamed: U8.1 (Q), U14.1 (A0)
unnamed: U8.15 (Q), U14.16 (A1)
PINK_NOISE: C30.1, J3.3, R38.1, U13.4 (SX0)
S&H_INT_CLK: J6.2, P1.3, R110.1
SAMPLE: R95.2, U13.8 (DX)
WHITE_NOISE: C31.1, J4.3, R39.1

Notes on the sheet:
POWER
GLIDE
S&H CLOCK RATE
10 VPP
***
***Adjustments to get 10 VPP TRI and 0.1 to 100 Hz range
This offsets the 200 mV FET pedestal voltage
Ian Fritz Super Sampe & Hold http://ijfritz.byethost4.com/super_sh_rand_web.pdf
SLEW_IN
SIMPLE SLEW FROM: http://4.bp.blogspot.com/_UZMTRL9r8vU/TTGv3KWKT1I/AAAAAAAAAGw/SQU2PrACBgo/s1600/slew.jpg http://synovatron.blogspot.co.uk/p/cv-tools-project.html
S&H EXT CLK
S&H_EXT_SAMPLE
SLEW_OUT
00 RANDOM 01 SINE 10 RAMP 11 EXT
POWER ON RESET
SWITCH DEBOUNCE
GROUND UNUSED CMOS INPUTS
RESET FLIP FLOPS TO '00' ON POWER UP
00 SINE 01 TRI 10 RAMP 11 PULSE
RAMP ADJUST
RESET
LEVEL TRIM
LFO OUT
NOISE
SAMPLE & HOLD
LFO
SWITCHING LOGIC
SLEW
NOISE LEVEL
DELAY TIME
FREQ
S&H OUT
**Work out correct gain makeup here
FREQ TRIM
INPUT PROTECTION DIODES HERE?
Normalize to selectable LFO output - allows selection of tri or pulse
trimmer here to adjust pedistal voltage precisely
Changed R8 to 120K Gives 50 mHz as lowest LFO rate
S&H TRI OUT
RANGE
LOG
Changed C27 to NP ceramic
Use C945 here
Increase to 6.8 or 10 to extend delay time?
NOISE AMPLIFIER CONFIGURED FOR BJT 4558. USE 4558 OR RE- CONFIGURE FOR TL07X?
current limit R here?
current limit R here?
Adjust R25 to 22K for reliable retriggering with 5V gate
Reduce R72 to 150K to get 10Vpp TRI output
SYSTEM80 INC. 2017
1.4
'850' modulation/noise source
LFO, S&H, NOISE, SLEW EURORACK MODULE
