minisystem/750-UTILITY/750 LFO S&H NOISE SLEW.kicad_pcb

## KiCad design 750 LFO S&H NOISE SLEW.kicad_pcb (continued)

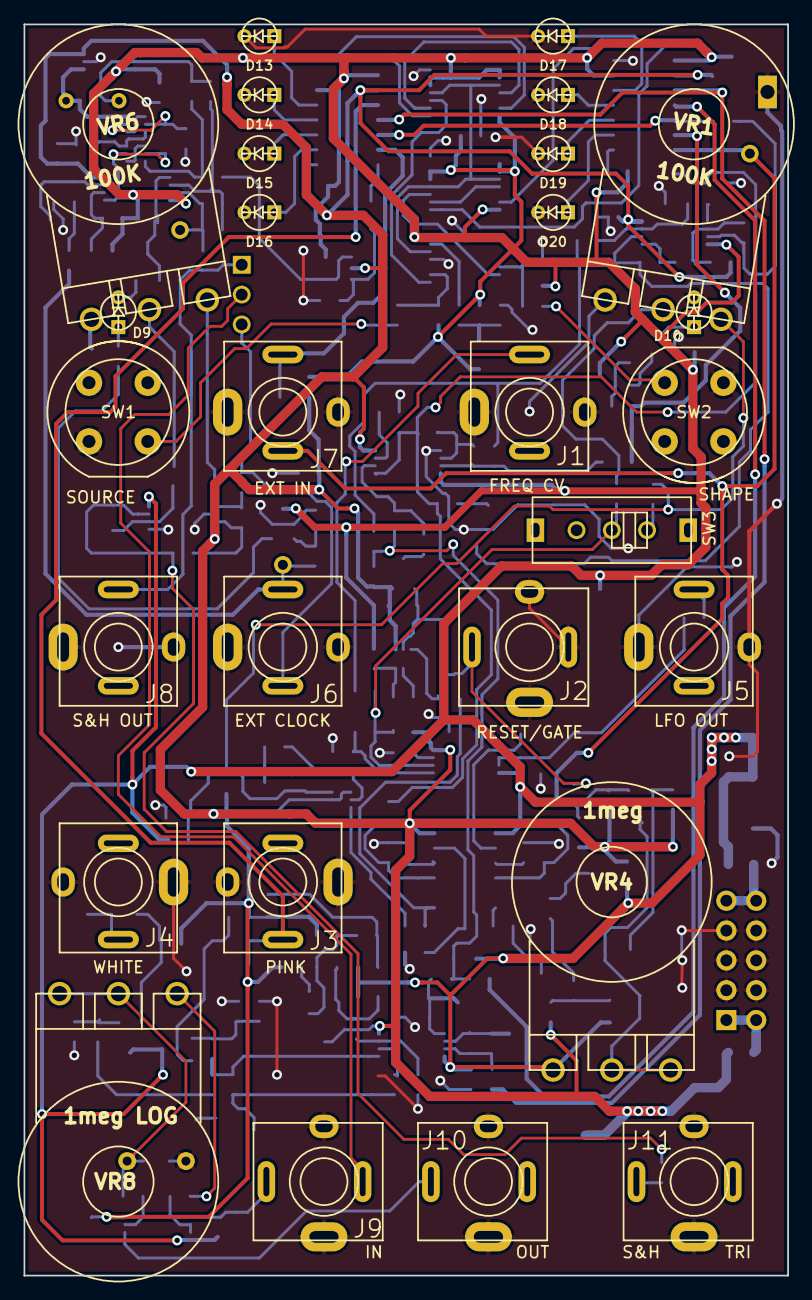
[picture p19: board 750 LFO S&H NOISE SLEW.kicad_pcb from above]

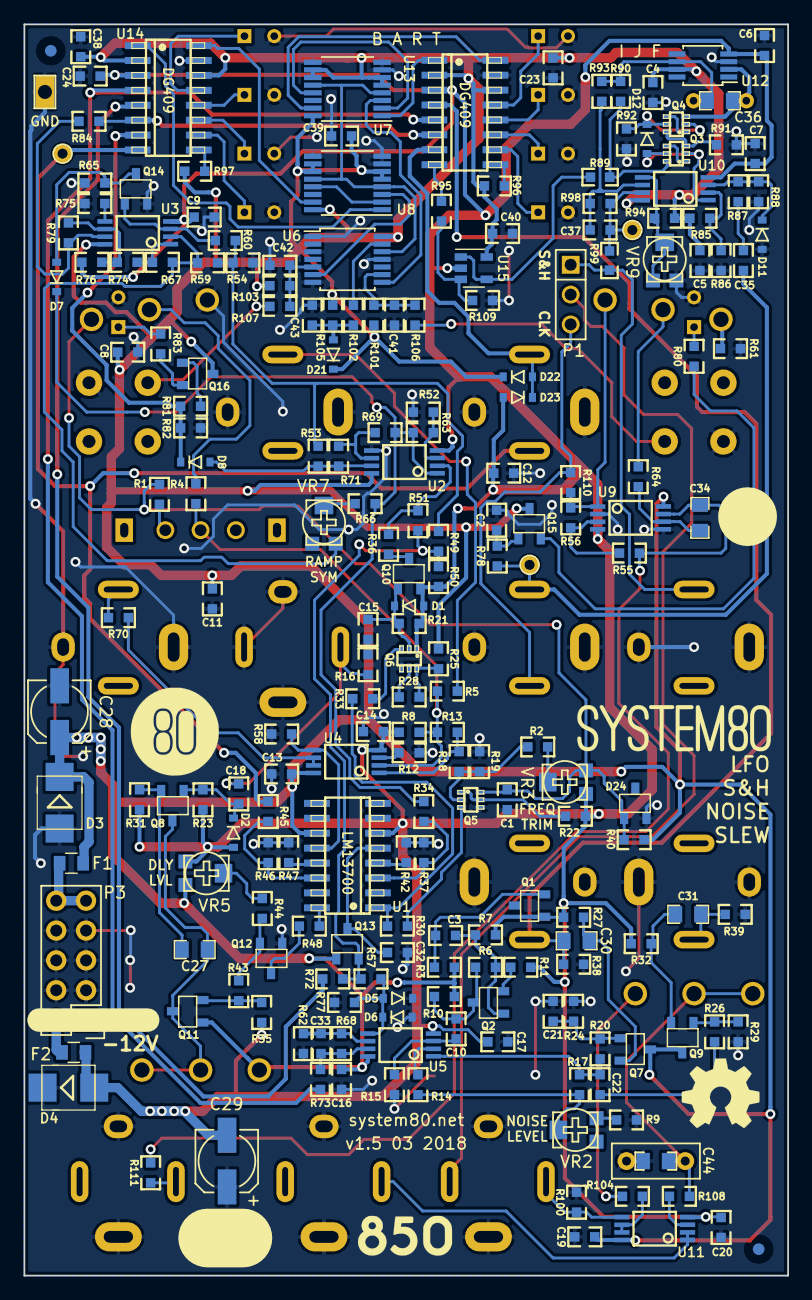
[picture p20: board 750 LFO S&H NOISE SLEW.kicad_pcb from below]

Board: 2 copper layers, 65.0 x 106.5 mm, 238 parts (210 on the bottom side), 145 nets.
