minisystem/750-UTILITY/(commit log)

2016-03-13 working on 150 LFO
    [750 LFO S&H NOISE SLEW.sch]
2016-03-14 schematic more or less captured. Still need to check and also confirm noise circuit
    [750 LFO S&H NOISE SLEW.sch]
2016-03-14 tidy up a bit. Could start part assignment and rough layout now
    [750 LFO S&H NOISE SLEW.sch]
2016-03-16 noise source done. removed redundant power-on-reset circuit
    [750 LFO S&H NOISE SLEW.sch]
2016-03-17 tidy up. next step: annotate
    [750 LFO S&H NOISE SLEW.sch]
2016-03-17 put PNP and NPN in LFO expo converter into single 3946 package, little bit of clean up
    [750 LFO S&H NOISE SLEW.sch]
2016-03-17 added filtered rails for noise circuit a la TR-808
    [750 LFO S&H NOISE SLEW.sch]
2016-03-18 annotated, footprints assinged, netlist generated
    [750 LFO S&H NOISE SLEW.sch]
2016-03-18 started placing comps on PCB. jacks, pots and LEDs placed
    [750 LFO S&H NOISE SLEW.sch]
2016-03-18 more component placement
    [750 LFO S&H NOISE SLEW.kicad_pcb, 750 LFO S&H NOISE SLEW.sch]
2016-04-09 placing components, starting a bit from scratch
    [750 LFO S&H NOISE SLEW.kicad_pcb, 750 LFO S&H NOISE SLEW.sch]
2016-04-10 placing and routing. so slow...
    [750 LFO S&H NOISE SLEW.kicad_pcb]
2016-04-11 almost done placing LFO, then on to S&H
    [750 LFO S&H NOISE SLEW.kicad_pcb]
2016-04-11 LFO all placed, partially routed
    [750 LFO S&H NOISE SLEW.kicad_pcb]
2016-04-12 everything placed but some test points and all decoupling caps
    [750 LFO S&H NOISE SLEW.kicad_pcb, 750 LFO S&H NOISE SLEW.sch]
2016-04-12 routing power
    [750 LFO S&H NOISE SLEW.kicad_pcb, 750 LFO S&H NOISE SLEW.sch]
2016-04-13 routing power and ground, all components placed
    [750 LFO S&H NOISE SLEW.kicad_pcb, 750 LFO S&H NOISE SLEW.sch]
2016-04-14 stitching ground plane
    [750 LFO S&H NOISE SLEW.kicad_pcb]
2016-04-16 tidy up
    [750 LFO S&H NOISE SLEW.kicad_pcb]
2016-05-27 adjust silkscreen
    [750 LFO S&H NOISE SLEW.kicad_pcb, 750 LFO S&H NOISE SLEW.sch]
2016-12-09 added notes to schematic based on building first prototype
    [750 LFO S&H NOISE SLEW.kicad_pcb, 750 LFO S&H NOISE SLEW.sch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]
2016-12-10 working on panel
    [750 LFO S&H NOISE SLEW.sch, panel outline.dxf]
2016-12-11 update schematic with changes for next version, still need to be implemented in pcb
    [750 LFO S&H NOISE SLEW.sch]
2016-12-11 import panel graphics hole centres into pcbnew
    [750 LFO S&H NOISE SLEW.kicad_pcb, hole centres.dxf]
2016-12-12 routing changes to pcb
    [750 LFO S&H NOISE SLEW.kicad_pcb, 750 LFO S&H NOISE SLEW.sch]
2016-12-13 almost done routing second version, 3 ground signals left to stitch
    [750 LFO S&H NOISE SLEW.kicad_pcb]
2016-12-13 update test point footprint, adjust silkscreen
    [750 LFO S&H NOISE SLEW.kicad_pcb, 750 LFO S&H NOISE SLEW.sch]
2016-12-18 silkscreen tweaking. getting ready to generate gerbers and order v1.1 PCBs
    [750 LFO S&H NOISE SLEW.kicad_pcb, 750 LFO S&H NOISE SLEW.sch]
2016-12-18 added buffer to s&h input
    [750 LFO S&H NOISE SLEW.kicad_pcb, 750 LFO S&H NOISE SLEW.sch]
2017-01-08 fixed a few reference positions
    [750 LFO S&H NOISE SLEW.kicad_pcb]
2017-03-20 fixed range switch pin swap. started moving top layer bypass cpas to bottom layer. still need to fix delay or slew pot pin mixup - can't remember which one is mixed up
    [750 LFO S&H NOISE SLEW.kicad_pcb, 750 LFO S&H NOISE SLEW.sch]
2017-03-20 moved all smt to bottom layer, swapped VR4 delay time pot pins
    [750 LFO S&H NOISE SLEW.kicad_pcb, 750 LFO S&H NOISE SLEW.sch]
2017-03-20 silkscreen tweaked, ready for panel check
    [750 LFO S&H NOISE SLEW.kicad_pcb, 750 LFO S&H NOISE SLEW.sch]
2017-03-21 finished panel mechanical layer
    [750 LFO S&H NOISE SLEW-Eco1.User.dxf, 750 LFO S&H NOISE SLEW-Edge.Cuts.dxf, 750 LFO S&H NOISE SLEW-F.SilkS.dxf]
2017-03-21 checked and ready to order PCB
    [750 LFO S&H NOISE SLEW.kicad_pcb]
2017-03-22 ordered PCBs, created dimensioned panel drawing for machinist
    [750 LFO S&H NOISE SLEW.kicad_pcb, 850_hole_centres.dwg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]
2017-04-21 working on v1.3. almost done
    [750 LFO S&H NOISE SLEW.kicad_pcb, 750 LFO S&H NOISE SLEW.sch]
2017-04-29 added a couple of superflurous output protection resistors
    [750 LFO S&H NOISE SLEW.kicad_pcb, 750 LFO S&H NOISE SLEW.sch]
2017-05-02 changed R25 value to improve LFO reset response
    [750 LFO S&H NOISE SLEW.sch]
2017-05-02 generated v1.3 gerbers for ordering
    [750 LFO S&H NOISE SLEW-B.Cu.gbl, 750 LFO S&H NOISE SLEW-B.Mask.gbs, 750 LFO S&H NOISE SLEW-B.SilkS.gbo, 750 LFO S&H NOISE SLEW-F.Cu.gtl, 750 LFO S&H NOISE SLEW-F.Mask.gts, 750 LFO S&H NOISE SLEW-F.SilkS.gto]
2017-05-25 commit before adding voltage referencd for LFO
    [750 LFO S&H NOISE SLEW.kicad_pcb]
2017-05-26 LFO voltage reference added and routed"
    l
    q
    ;ksadjf
    q
    exit
    "
    [750 LFO S&H NOISE SLEW.kicad_pcb, 750 LFO S&H NOISE SLEW.sch]
2017-05-29 850 gerbers plotted
    [750 LFO S&H NOISE SLEW.kicad_pcb, 750 LFO S&H NOISE SLEW.sch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]
2017-06-23 export BOM
    [750 LFO S&H NOISE SLEW.kicad_pcb, 850_BOM.csv]
2017-08-06 started working on manual, added BOM
    [750 LFO S&H NOISE SLEW.kicad_pcb, 850_BOM.xlsx]
2017-09-04 working on manual
    [750 LFO S&H NOISE SLEW.sch]
2018-03-11 commit with updated PCB graphics, about to change 0603 footprints via text edit of pcb file
    [750 LFO S&H NOISE SLEW.kicad_pcb]
2018-03-14 last commit before changing 0603 footprints
    [750 LFO S&H NOISE SLEW.kicad_pcb]
